D4ryl00/42-badgotron/BADGOTRON/HUGO DESIGN TROP SWAG/niel.png

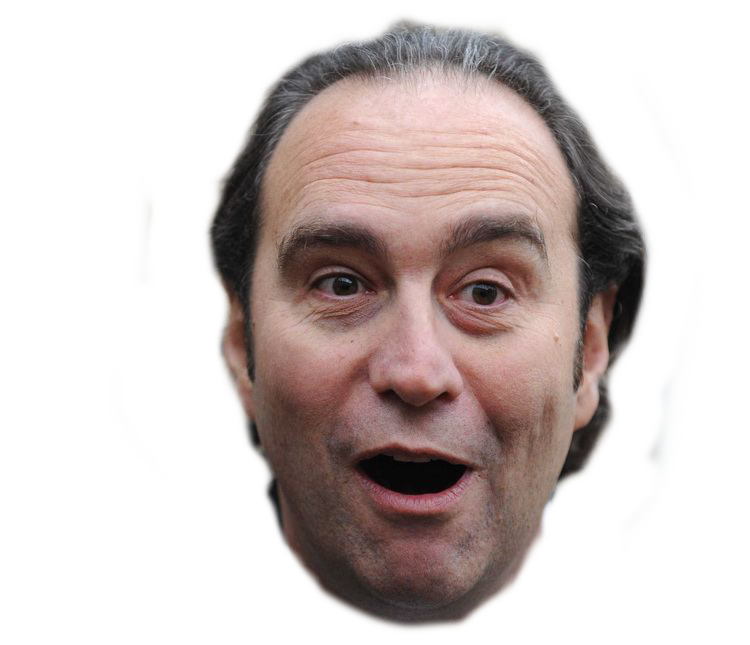
BADGOTRON/HUGO DESIGN TROP SWAG/niel.png
