D4ryl00/42-badgotron/README.md

# 42-badgotron

This is a digital electronic project at 42 (Paris).
Based on Microship PIC32 chip, this access card reader enables us (students) to know how much time we have stayed in the school this day, this week, this month, or this trimester.
