D4ryl00/42-badgotron/BADGOTRON/Firmware/Docs/Notes.txt

Mettre les pins non connectées en output et en low-level.
