D4ryl00/42-badgotron/BADGOTRON/Datasheets/cableRS.PNG

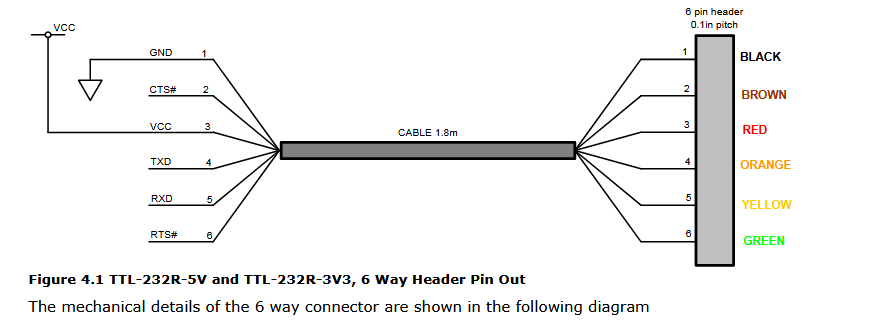
BADGOTRON/Datasheets/cableRS.PNG
