D4ryl00/42-badgotron/BADGOTRON/Firmware/Docs/Lecteur RFID Pont diviseur.PNG

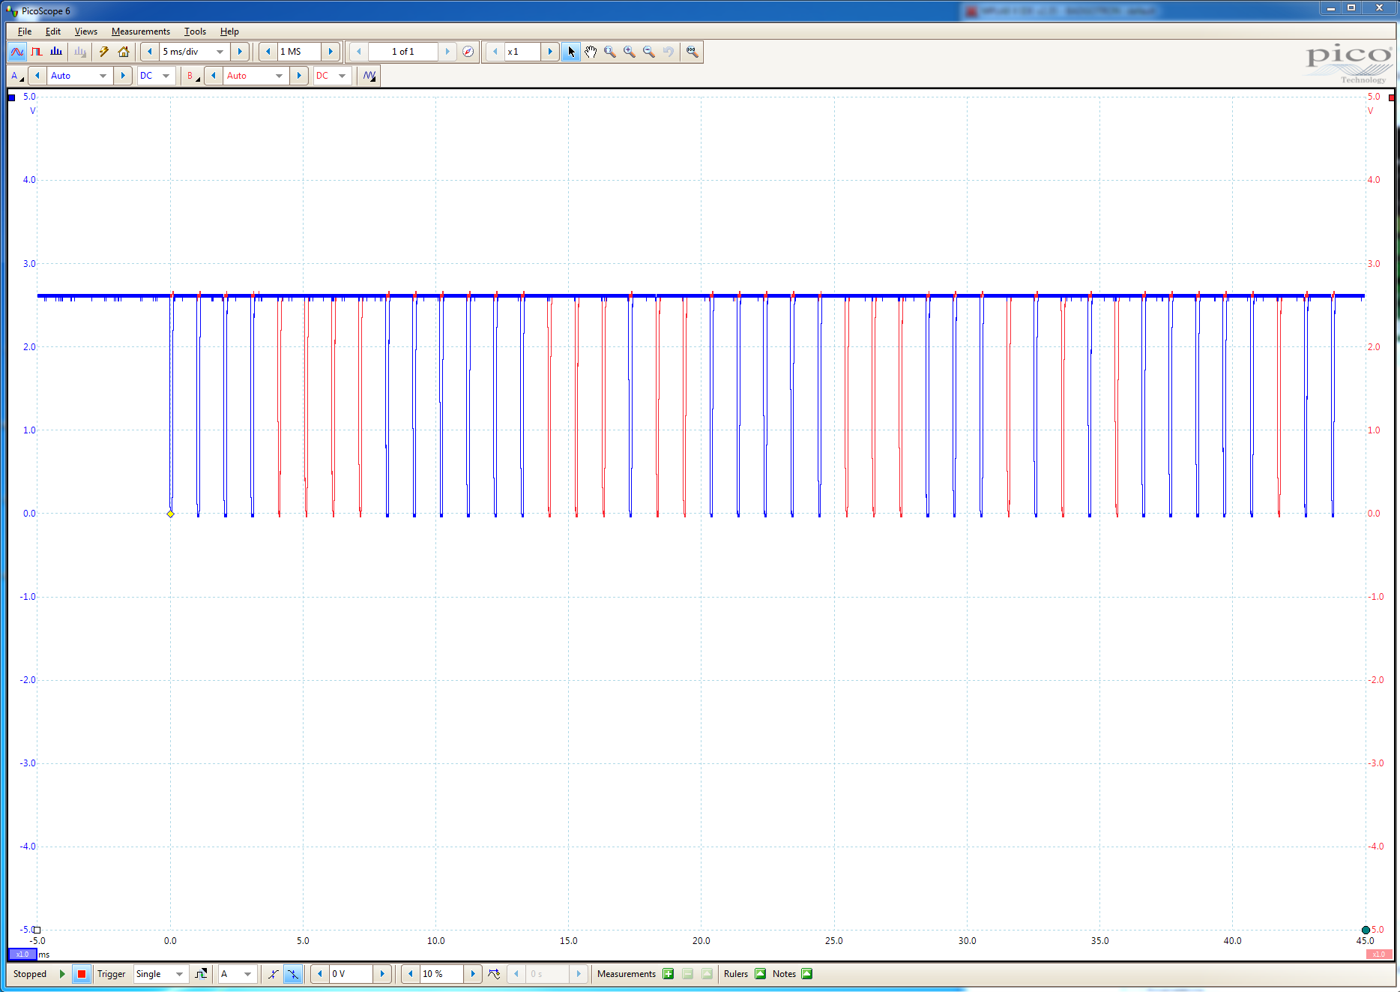
BADGOTRON/Firmware/Docs/Lecteur RFID Pont diviseur.PNG
