D4ryl00/42-badgotron/BADGOTRON/Schemas/Reg.PNG

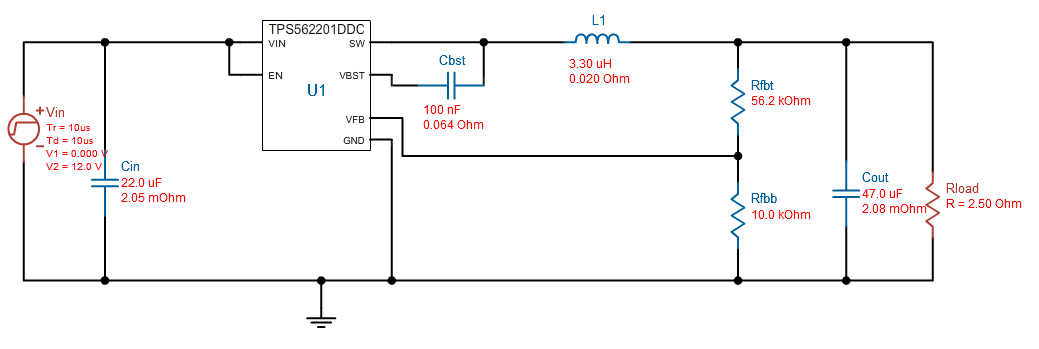
BADGOTRON/Schemas/Reg.PNG
