D4ryl00/42-badgotron/TP2/OUTPUT/BOM/Bill of Materials-PCB_Project_4.xlsx

Quantity | LogicalDesignator | Comment | Footprint | Description | Fabricant | Ref.Fabricant | Fournisseur | Ref.Fournisseur | Precision
7 | C1, C2, C3, C4, C5, C6, C15 | 100nF | CAPC1608N | Capacitor |  |  |  |  | 50V X5R
2 | C7, C8 | 20pF | CAPC1608N | Capacitor |  |  |  |  | 50V X5R
4 | C9, C11, C12, C13 | 10uF | CAPC2012N | Capacitor | TDK | C2012X5R0J106M/1.25 | Farnell | 2309029 | 6.3V X5R 10uF
2 | C10, C14 | 1uF | CAPC1608N | Capacitor |  |  |  |  | 6.3V X5R
5 | D1, D1, D1, D1, D4 | Green LED | LED 0805 | Typical INFRARED GaAs LED | KING BRIGHT | KPT-2012SGC | Farnell | 2099239
2 | D2, D3 | GF1A | 214AC_21 | Default Diode | VISHAY | 6FIA-E3/67A | Farnell | 9549560
1 | FB1 | 600r | INDC1608AN | Inductor | WURTH | 472792651 | Farnell | 1635706
1 | J1 | Program / Debug | RJ12_90 |  | Tyco | 1-215876-3 | Farnell | 1773039
1 | P1 | 12V Main | PHOENIX_1985195 | Header, 2-Pin | PHOENIX CONTACT | PTSA 1.5/2-3,5-Z | Farnell | 1792769
1 | P2 | 12V Battery | PHOENIX_1985195 | Header, 2-Pin | PHOENIX CONTACT | PTSA 1.5/2-3,5-Z | Farnell | 1792769
1 | R1 | 1K | PDB181-K415K-102A2 | Potentiometer | BOURNS | PDB181-K415K-102A2 | Farnell | 1823540
4 | R2 | 330r | RESC1608N | Resistor |  |  |  |  | 1%
1 | R3 | 4.7k | RESC1608N | Resistor |  |  |  |  | 1%
1 | R4 | 470r | RESC1608N | Resistor |  |  |  |  | 1%
1 | U1 | PIC32MX764F128H-I/PT | QFP50P1200X1200X120-64 | PIC32MX764F128H-I/PT | Microchip | PIC32MX764F128H-I/PT | Farnell | 1971889
1 | U2 | AP1117 | TD03B_N |  | DIODES INC | AP1117D33G-13 | Farnell | 1825285
1 | Y1 | 8MHz | HC49/4H SMX Crystal | Crystal Oscillator | FOX ELECTRONICS | FOXSDLF/080-20 | Farnell | 2063972
