D4ryl00/42-badgotron/BADGOTRON/Schemas/Project Outputs for badgotron/BOM/Bill of Materials-badgotron.xlsx

Quantity | Designator | Comment | Footprint | Description | Fabricant | Ref.Fabricant | Fournisseur | Ref.Fournisseur
13 | C8, C10, C12, C14, C15, C16, C17, C18, C19, C20, C21, C22, R9 | 0.1uF, 22uF, 22uF, 10uF, 10uF, 0.1uF, 0.1uF, 22uF, 22uF, 10uF, 10uF, 0.1uF, 33.2K | 0603 | Reg_5v, Reg_5v, Reg_5v, Reg_5v, Reg_5v, Reg_5v, Reg_5v, Reg_5v, Reg_5v, Reg_5v, Reg_5v, Reg_5v, Resistor | CAHIER | CAHIER | CAHIER | CAHIER
4 | C5, C7, C9, C11 | 0.1uF | 0603 | Capacitor | Multicomp | MCY4C3B104M160CT | Farnell | 2310273
3 | R2, R3, R13 | 300k | 0603 | Resistor | MULTICOMP | MCSR08X3003FTL | Farnell | 2074433
3 | R4, R5, R16 | 100k | 0603 | Resistor | MULTICOMP | MCWR06X1003FTL | Farnell | 2447226
3 | R8, R10, R12 | 10K | 0603 | Resistor | TE CONNECTIVITY | CPF0201D10KC1 | Farnell | 2117887
2 | C1, C2 | 18pF | 0603 | Capacitor | AVX | 02013A180JAT2A | Farnell | 1740563
2 | Q1, Q2 | MOSFET-N | nouveau_mosfetN | N-Channel MOSFET | ON SEMICONDUCTOR | 1HN04CH-TL-W | Farnell | 2727912
2 | R6, R14 | 330 | 0603 | Resistor | TE Connectivity | RN73C1J232RBTDF | Farnell | 2687973
2 | U2, U4 | TPS562201DDCT | TPS562201DDCT | Reg 12V-5V | TPS562201DDCT | Texas Instrument | Farnell | 2527034
1 |  | Lecteur_Badge_LXM |  |  | Stid-Security | LXM_WIEGAND44b | Gregoire | :)
1 | B1 | Motor Servo | RAD-0.4 | Servo Motor | Olimex | MS-R-1.3-9 | Olimex | MS-R-1.3-9
1 | C13 | 1000uF | Condo_trav | Capacitor | Multicomp | MCGLR16V108M10X16 | Farnell | 1902972
1 | C3 | 10uF | C3 |  | VISHAY | TL3C106K025C0450.. | Farnell | 2353238
1 | C4 | 100nF | 0603 | Capacitor | WURTH ELECTRONIK | 885342211005 | Farnell | 2812613
1 | C6 | 22uF | 0603 | Cout_Reg_3.3v | AVX | 12103D226KAT2A | Farnell | 1833829
1 | D1 | Diode 10TQ035 | DiodeZin | Diode Zenner | ON SEMICONDUCTOR | MM3Z15VB | Farnell | 2453991
1 | D4 | LedBlancheRetroEcl | LED-0 | LED Blanche retro vumetre | N/A | N/A | BARBIE | N/A
1 | DS1 | 20x4 LCD |  |  | Midas | MC42008A6W-FPTLW | Farnell | 2606880
1 | F1 | Fuse 1 | FUSIBLE | Fuse | Littelfuse | 39515000000 | Farnell | 1596504
1 | L1 | 4.7uH | Bobine Traversante 4.7 | L_Reg_5v | BOURNS | RLB0914-4R7ML | Farnell | 2309248
1 | L2 | 3.3uH | Bobine Traversante 4.7 | L_Reg_3v | BOURNS | RLB0912-3R3ML | Farnell | 2309234
1 | MCL039PURGW | Led RG |  | Led RG | Multicomp | MCL039PURGW | Farnell | 1581194
1 | P1 | 61304021121 | HDR2X5 | Header, 5-Pin, Dual row | WURTH ELEKTRONIK | 61304021121 | Farnell | 2356148
1 | P2 | 31101112 | Bornier12 | Header, 12-Pin | METZ CONNECT | 31101112 | Farnell | 1909750
1 | P3 | 90512-001LF | RJ12 | PortRJ12_debug | Amphenol ICC | 90512-001LF | Farnell | 1097914
1 | P4 | FC681465P | JackAlim | Power connector | CLIFF | FC681465P | Farnell | 1854512
1 | P5 | BCS-116-L-S-TE | HDR1X12 | Header, 12-Pin | Samtec | BCS-116-L-S-TE | Farnell | 1667483
1 | PS1 | Support Pile | Pile | Support Pile | Renata | SMTU-1225-1-LF | Farnell | 1216353
1 | R1 | 20k | POTARD | Potentiometer | VISHAY | M63S203KB40 | Farnell | 9609822
1 | R11 | 1Ko | 0603 | Resistor | TE CONNECTIVITY | CPF0201D1K0E1 | Farnell | 2117780
1 | R17 | 60.4 | 0603 | Resistor | TE CONNECTIVITY | RP73PF1E60R4BTDF | Farnell | 2838800
1 | R18 | 75 | 0603 | Resistor | TE CONNECTIVITY | CPF0805B75RE1 | Farnell | 1697415
1 | R7 | 54.9K | 0603 | Resistor | TE CONNECTIVITY | CPF0402B54K9E1 | Farnell | 2330744
1 | S1 | Bouton Status | SPST-2 | Switch | RAFI | 1.10.001.001/0205 | Farnell | 9927360
1 | U1 | 74LVX4245MTCX | TRANS | Bus Transceiver | ON SEMICONDUCTOR | 74LVX4245MTCX | Farnell | 1467357
1 | U3 | SST25VF016B-50-4C-S2AF-T | FLASH | FLASH | Microchip | SST25VF016B-50-4I-S2AF-T | Farnell | 2774943
1 | U6 | LM809M3-3.08/NOPB | LM809 | Voltage Monitor | TEXAS INSTRUMENTS | LM809M3-3.08/NOPB | Farnell | 2352609
1 | U7 | MCP79510-I/MS | rtc | RTC | Microchip | MCP79510-I/MS | Farnell | 2361124
1 | XDS1 | 1-826629-6 | HDR1X16 | Header, 16-Pin | AMP-TE CONNECTIVITY | 1-826629-6 | Farnell | 1248124
1 | Y1 | 32.768kHz | QUARTZ32KHz | Crystal Oscillator | ABRACON | ABS07-32.768KHZ-7-T | Farnell | 1838935
1 | Z1 | PIC32MX170F256D-I/PT | TQFP-44_L | PIC | MICROCHIP | PIC32MX170F256D-I/PT | Farnell | 2456845
