D4ryl00/42-badgotron/Sujets/Hardware/TP2/Bill of Materials/Bill of Materials.xls

BILL OF MATERIALS
Projet : |  | TP2.PrjPcb |  |  | Toutes résistances 1% sauf indication contraire
Date creation : |  | 28/01/2015 | 17:28:42 |  | Tous condensateurs X5R 6.3V minimum sauf indication contraire
Date impression : |  | 2015-01-28 | 17:28:44 |  | Condensateurs <= 100nF : C0G ou NP0 préférables
Quantity | LogicalDesignator | Comment | Footprint | Description | Fabricant | RefFabricant | Fournisseur | RefFournisseur | Precision | #Column Name Error:Notes
7 | C1, C2, C3, C4, C5, C6, C15 | 100nF | CAPC1608N | Capacitor |  |  |  |  | 50V X5R
2 | C7, C8 | 20pF | CAPC1005N | Capacitor |  |  |  |  | 50V X5R
4 | C9, C11, C12, C13 | 10uF | CAPC2012N | Capacitor | TDK | C2012X5R0J106M/1.25 | Farnell | 2309029 | 6,3V X5R
2 | C10, C14 | 1uF | CAPC1608N | Capacitor |  |  |  |  | 6,3V X5R
5 | D1, D1, D1, D1, D4 | Green LED | LED 0805 | Typical INFRARED GaAs LED | KINGBRIGHT | KPT-2012SGC | Farnell | 2099239
2 | D2, D3 | GF1A | SMA/DO-214AC_21 | Default Diode | VISHAY | GF1A-E3/67A | Farnell | 9549560
1 | FB1 | 600r | INDC1608AN | Inductor | Wurth | 742792651 | Farnell | 1635706
1 | J1 | Program / Debug | MOLEX 6P 1.25 CMS |  | Molex | 53398-0671 | Farnell | 1125368
1 | P1 | 12V Main | PHOENIX_1985195 | Header, 2-Pin | PHOENIX CONTACT | PTSA 1.5/2-3,5-Z | Farnell | 1792769
1 | P2 | 12V Battery | PHOENIX_1985195 | Header, 2-Pin | PHOENIX CONTACT | PTSA 1.5/2-3,5-Z | Farnell | 1792769
1 | R1 | 1K | PDB181-K415K-102A2 | Potentiometer | BOURNS | PDB181-K415K-102A2 | Farnell | 1823540
4 | R2 | 330r | RESC1608N | Resistor |  |  |  |  | 1%
1 | R3 | 4.7k | RESC1608N | Resistor |  |  |  |  | 1%
1 | R4 | 470r | RESC1608N | Resistor |  |  |  |  | 1%
1 | U1 | PIC32MX764F128H-I/PT | QFP50P1200X1200X120-64 | PIC32MX764F128H | Microchip | PIC32MX764F128H-I/PT | Farnell | 1971889
1 | U2 | AP1117 | TD03B_N | 1A LDO, 18V input, DPAK | DIODES INC | AP1117D33G-13 | Farnell | 1825285
1 | Y1 | 8MHz | XTAL139X50X45 | Crystal Oscillator | FOX ELECTRONICS | FOXSDLF/080-20 | Farnell | 2063972
