D4ryl00/42-badgotron/TP2/ZZ-POUBELLEPASSUR/Project Outputs for Free Documents/BOM/Bill of Materials-PCB_Project_4.xlsx

Comment | Description | Designator | Footprint | LibRef | Quantity
100nF | Capacitor | C1, C2, C3, C4, C5, C6, C15 | RAD-0.3 | Cap | 7
20pF | Capacitor | C7, C8 | RAD-0.3 | Cap | 2
10uF | Capacitor | C9, C11, C12, C13 | RAD-0.3 | Cap | 4
1uF | Capacitor | C10, C14 | RAD-0.3 | Cap | 2
Green LED | Typical INFRARED GaAs LED | D1_LED0, D1_LED1, D1_LED2, D1_LED3, D4 | LED-0 | LED0 | 5
GF1A | Default Diode | D2, D3 | SMC | Diode | 2
600r | Inductor | FB1 | 0402-A | Inductor | 1
Program / Debug |  | J1 |  | Program / Debug | 1
12V Main | Header, 2-Pin | P1 | HDR1X2 | Header 2 | 1
12V Battery | Header, 2-Pin | P2 | HDR1X2 | Header 2 | 1
1K | Potentiometer | R1 | VR5 | RPot | 1
330r | Resistor | R2_LED0, R2_LED1, R2_LED2, R2_LED3 | AXIAL-0.3 | Res1 | 4
4.7k | Resistor | R3 | AXIAL-0.3 | Res1 | 1
470r | Resistor | R4 | AXIAL-0.3 | Res1 | 1
AP1117 |  | U2 |  | AP1117 | 1
PIC32MX764F128H-I/PT |  | U? |  | PIC32MX764F128H-I/PT | 1
8MHz | Crystal Oscillator | Y1 | R38 | XTAL | 1
