D4ryl00/42-badgotron/BADGOTRON/Schemas/Project Outputs for badgotron/Schematic Prints/Schematic Prints.PDF

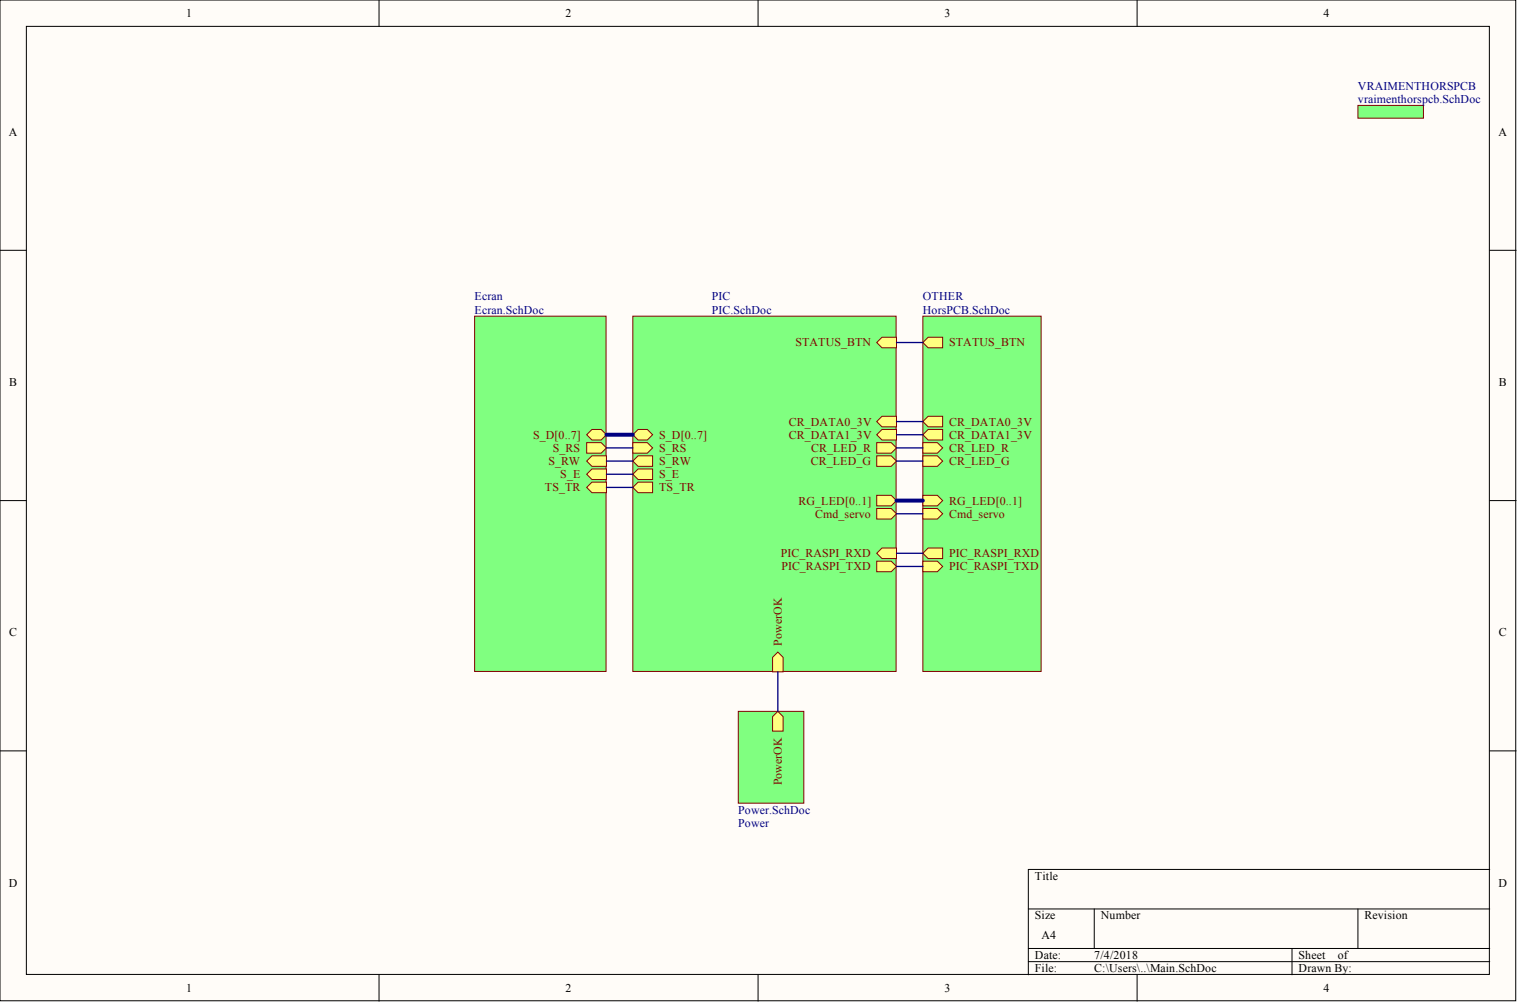
[picture p5: page 1]

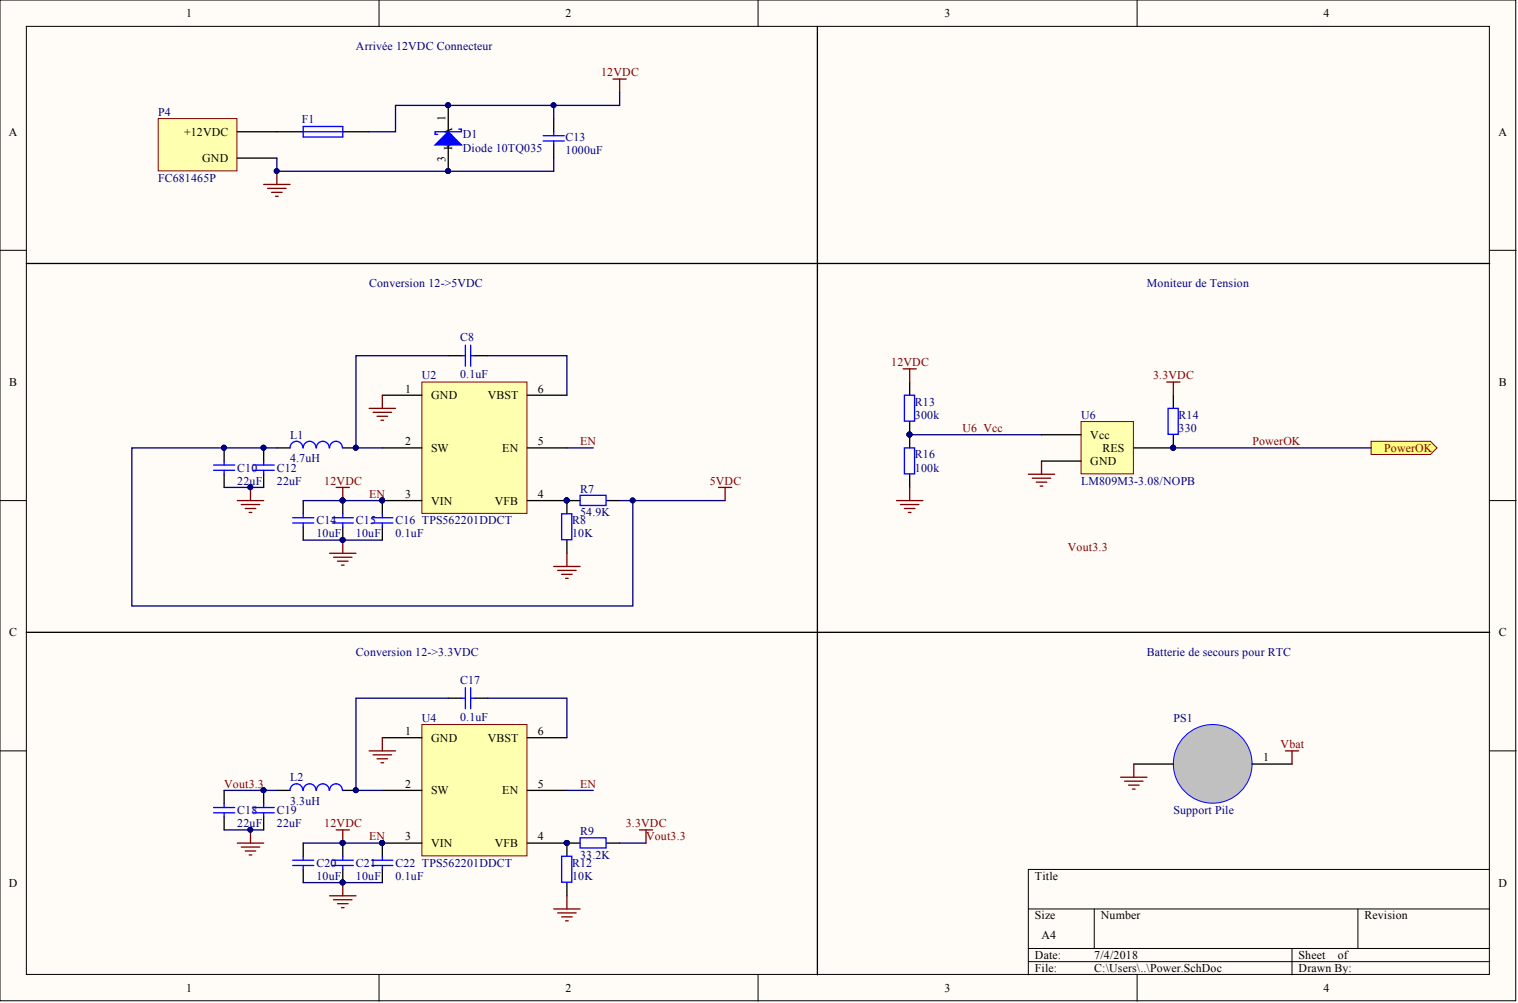
[picture p6: page 2]

Batterie de secours pour RTC

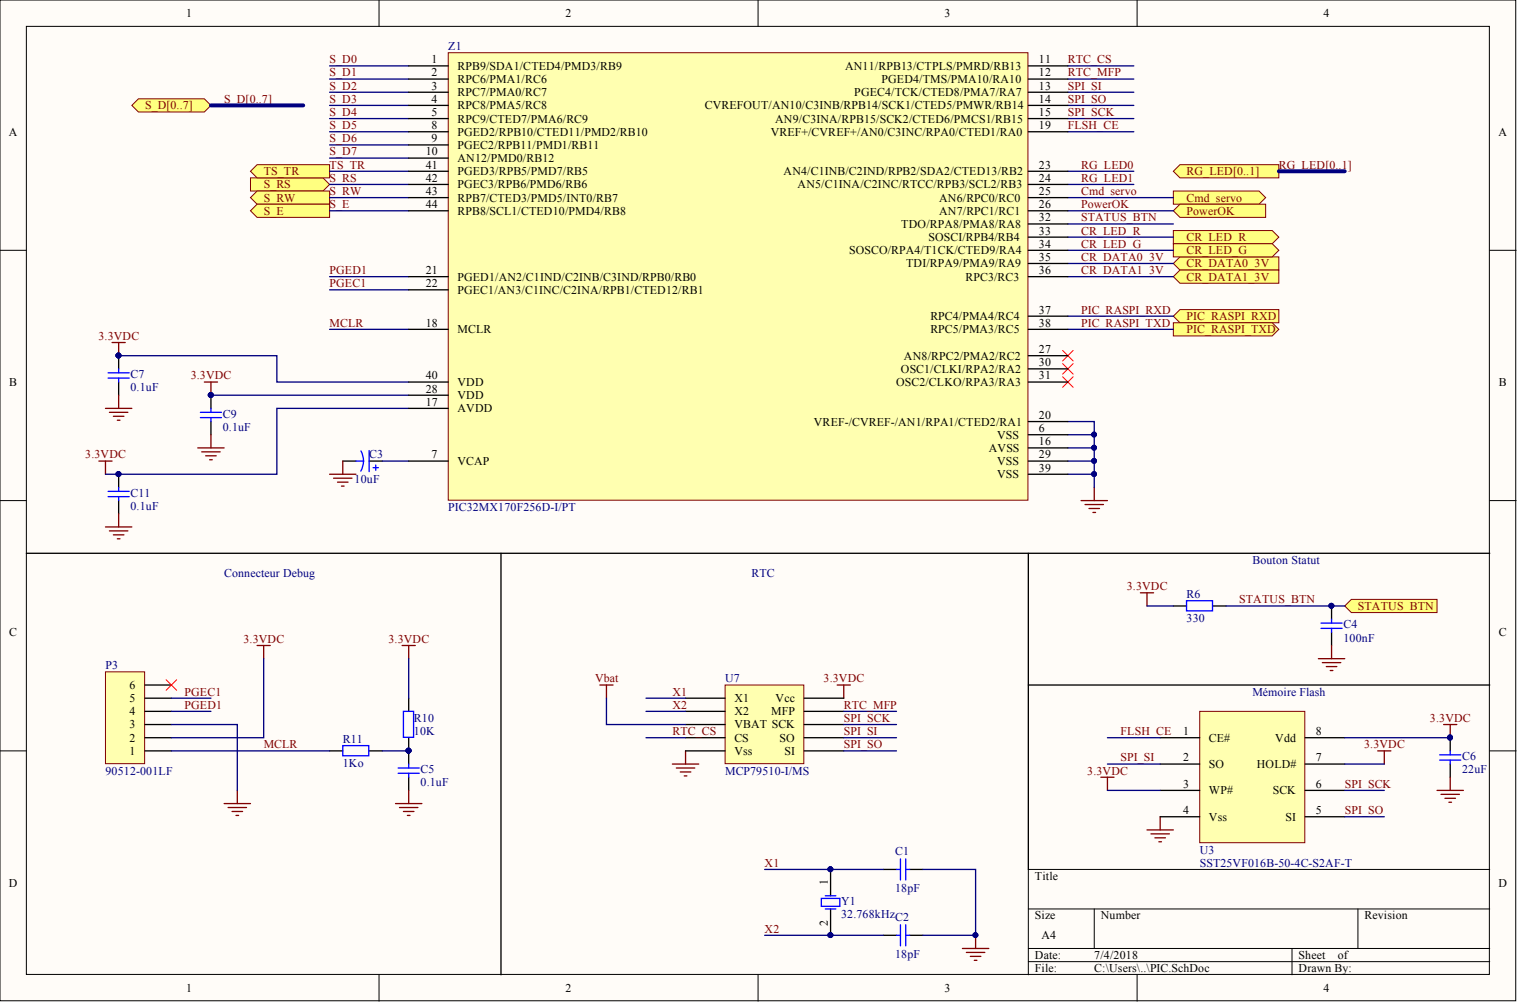
[picture p7: page 3]

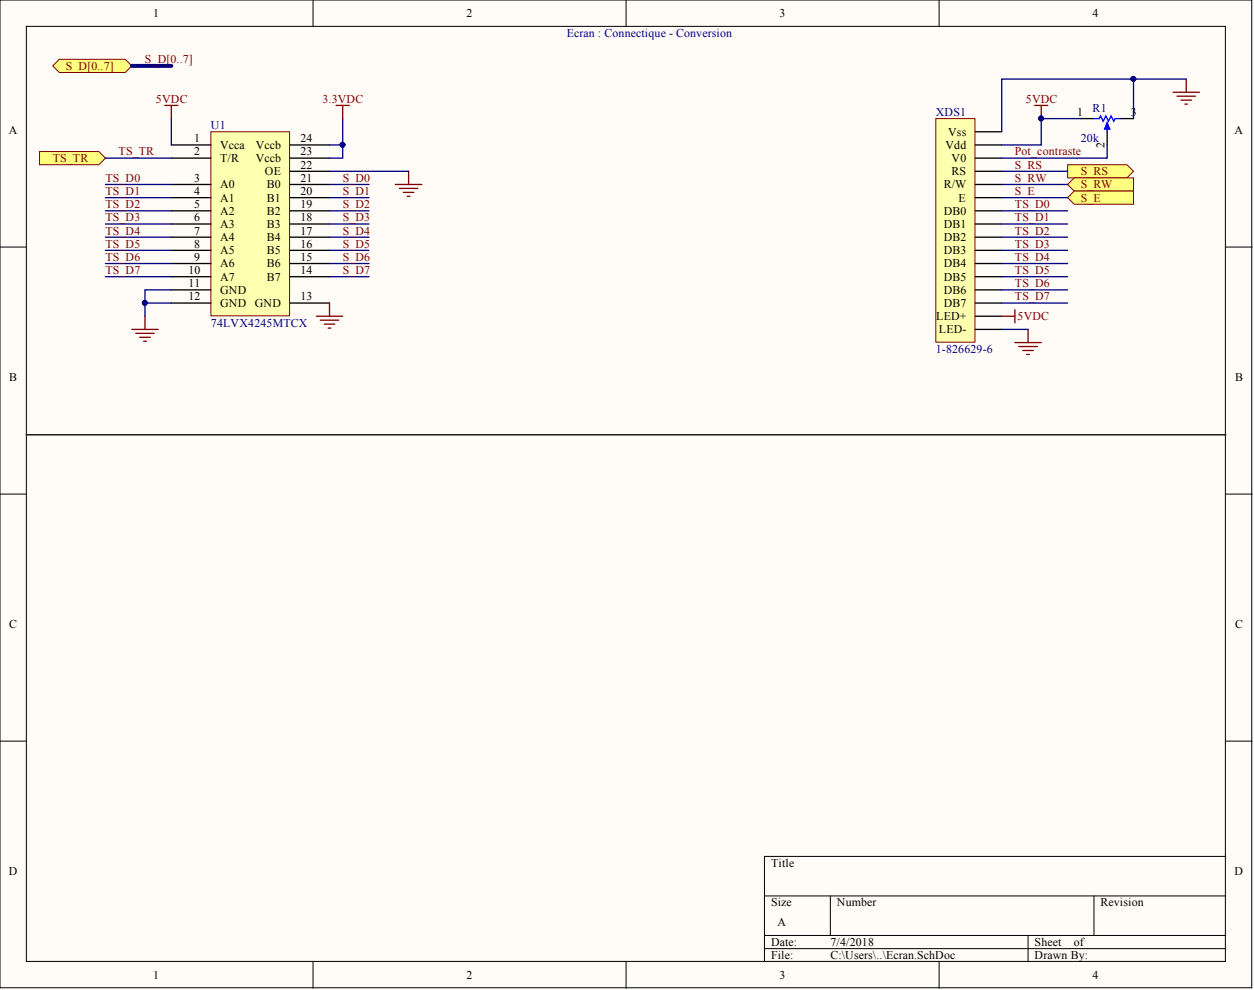
[picture p8: page 4]

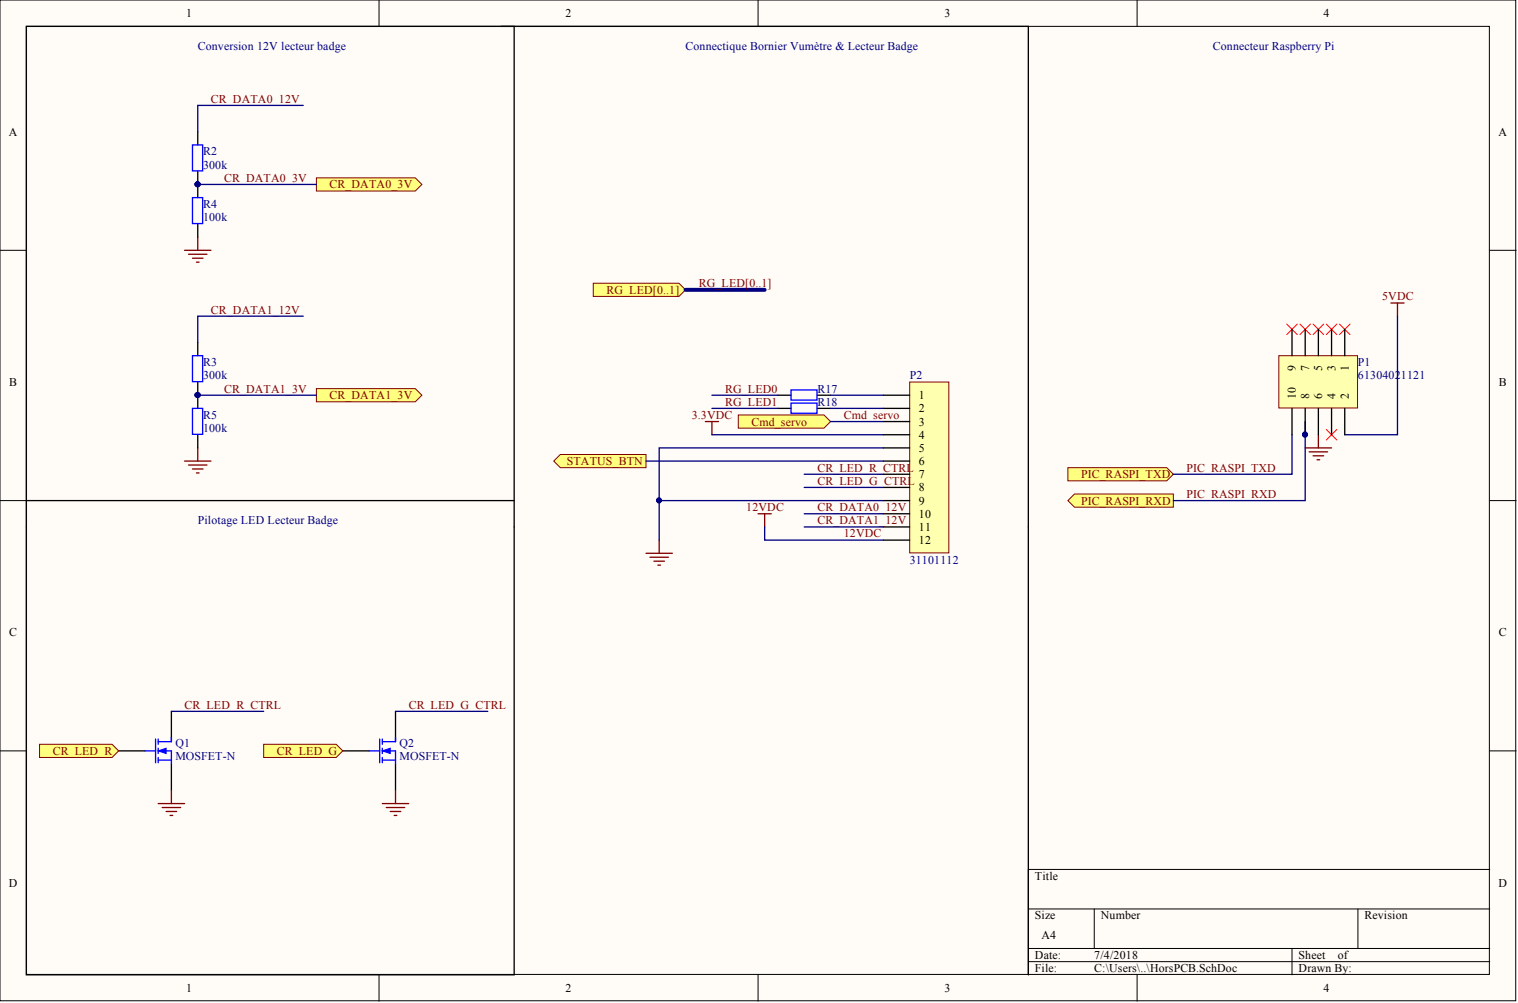
[picture p9: page 5]

Connectique Bornier Vumètre & Lecteur Badge

CR_LED_R_CTRL CR_LED_G_CTRL

12VDC CR_DATA0_12V

Pilotage LED Lecteur Badge

12VDC | 11 12

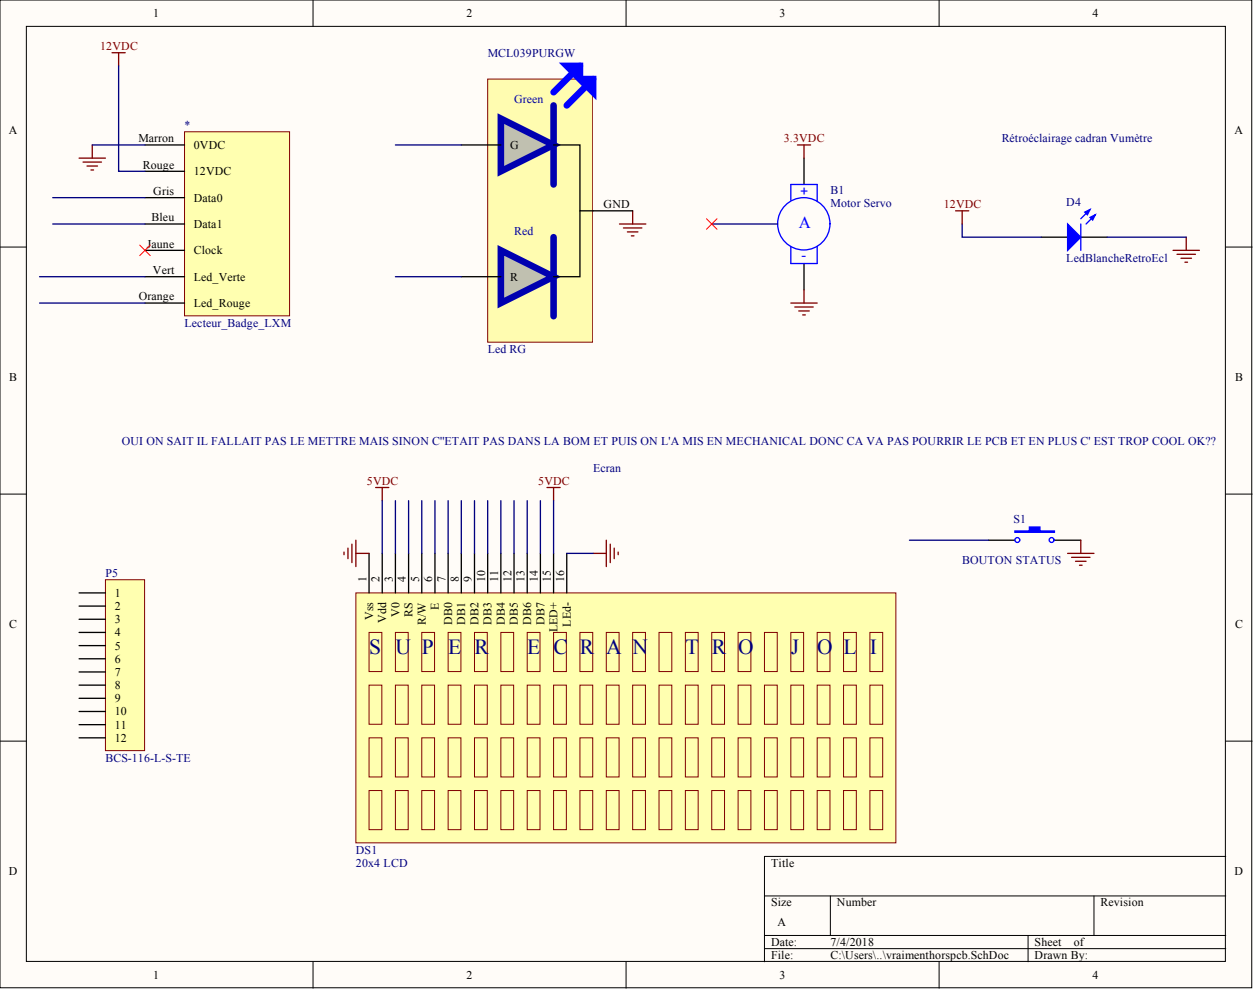
[picture p10: page 6]

OUI ON SAIT IL FALLAIT PAS LE METTRE MAIS SINON C''ETAIT PAS DANS LA BOM ET PUIS ON L'A MIS EN MECHANICAL DONC CA VA PAS POURRIR LE PCB ET EN PLUS C' EST TROP COOL OK??
