D4ryl00/42-badgotron/BADGOTRON/Schemas/Schemas_Annotes_19.04.pdf

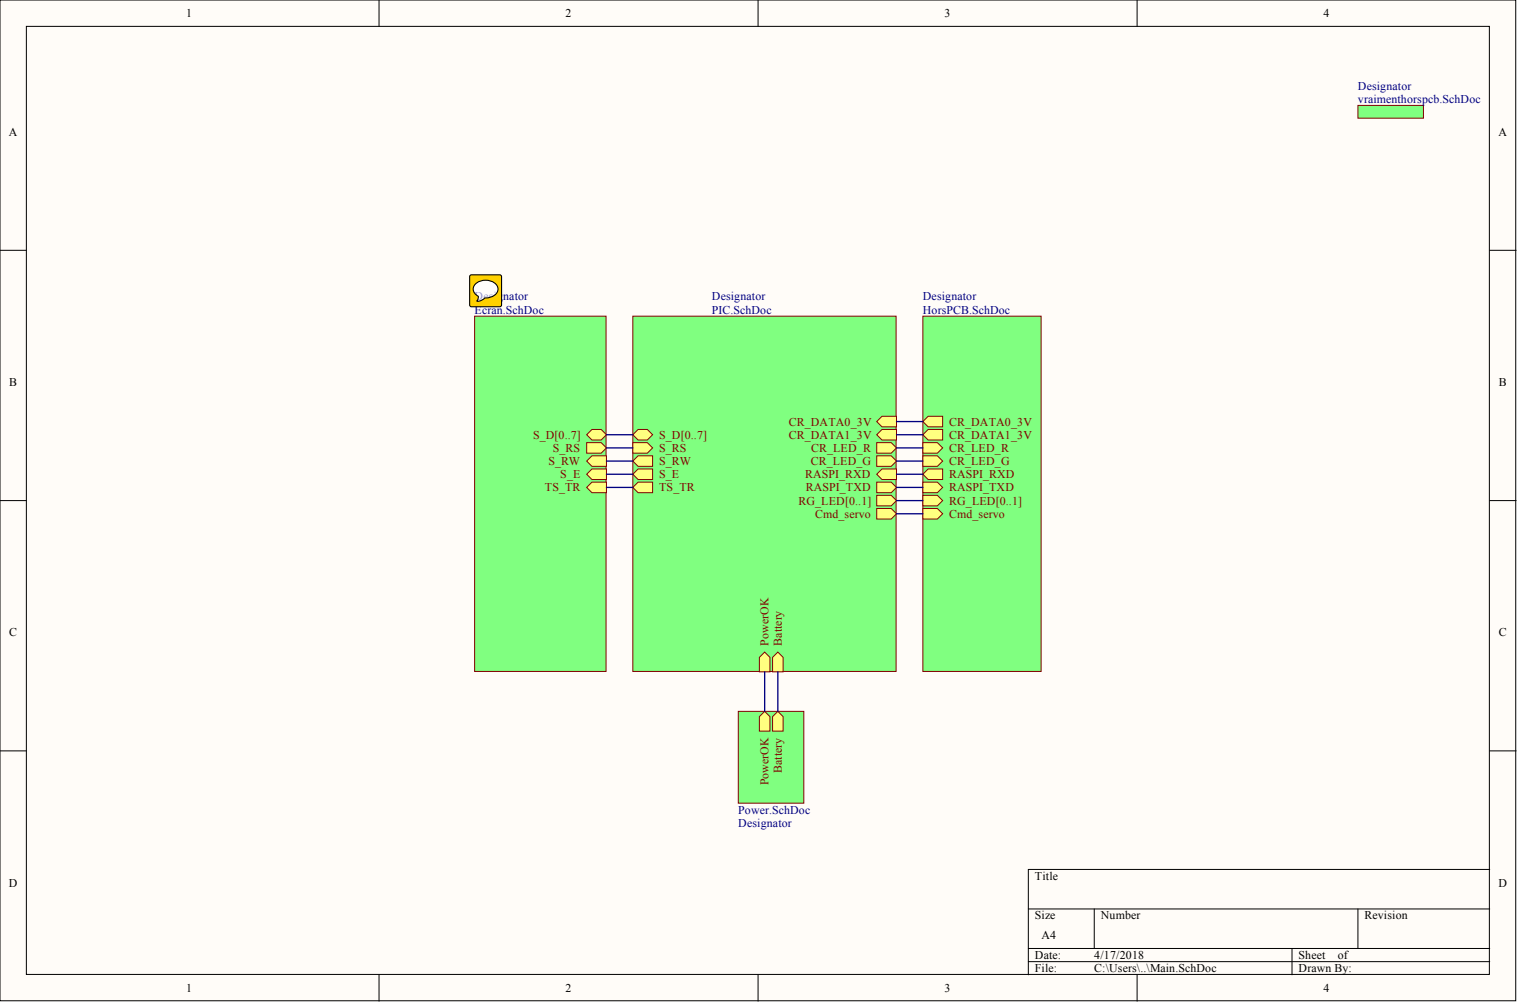
[picture p11: page 1]

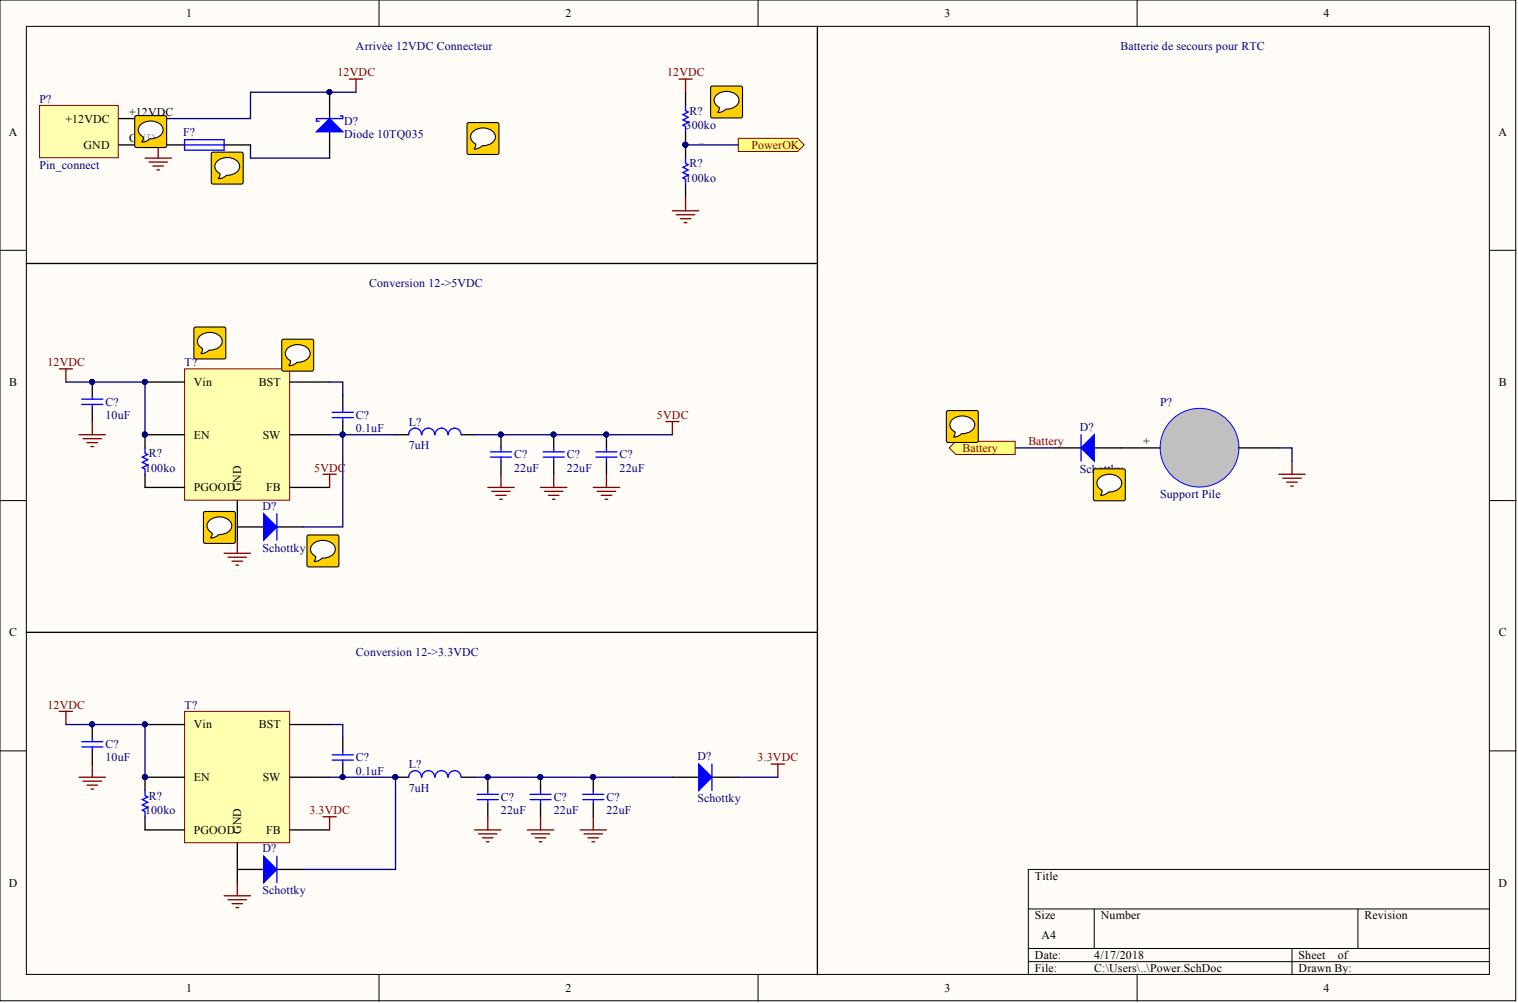
[picture p12: page 2]

Batterie de secours pour RTC

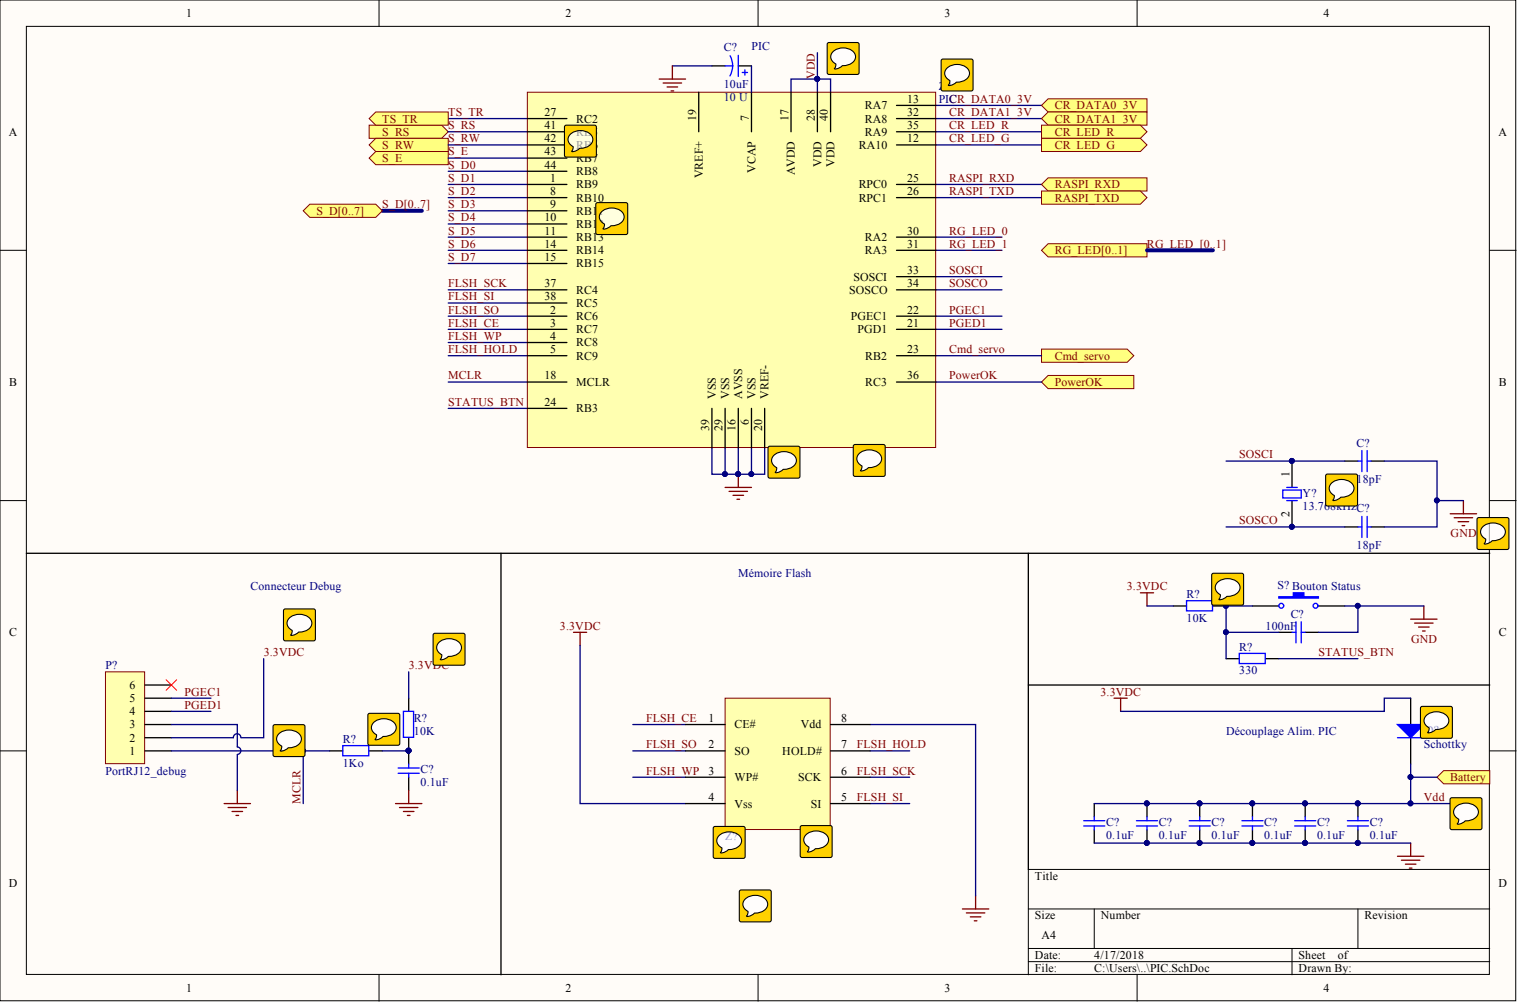
[picture p13: page 3]

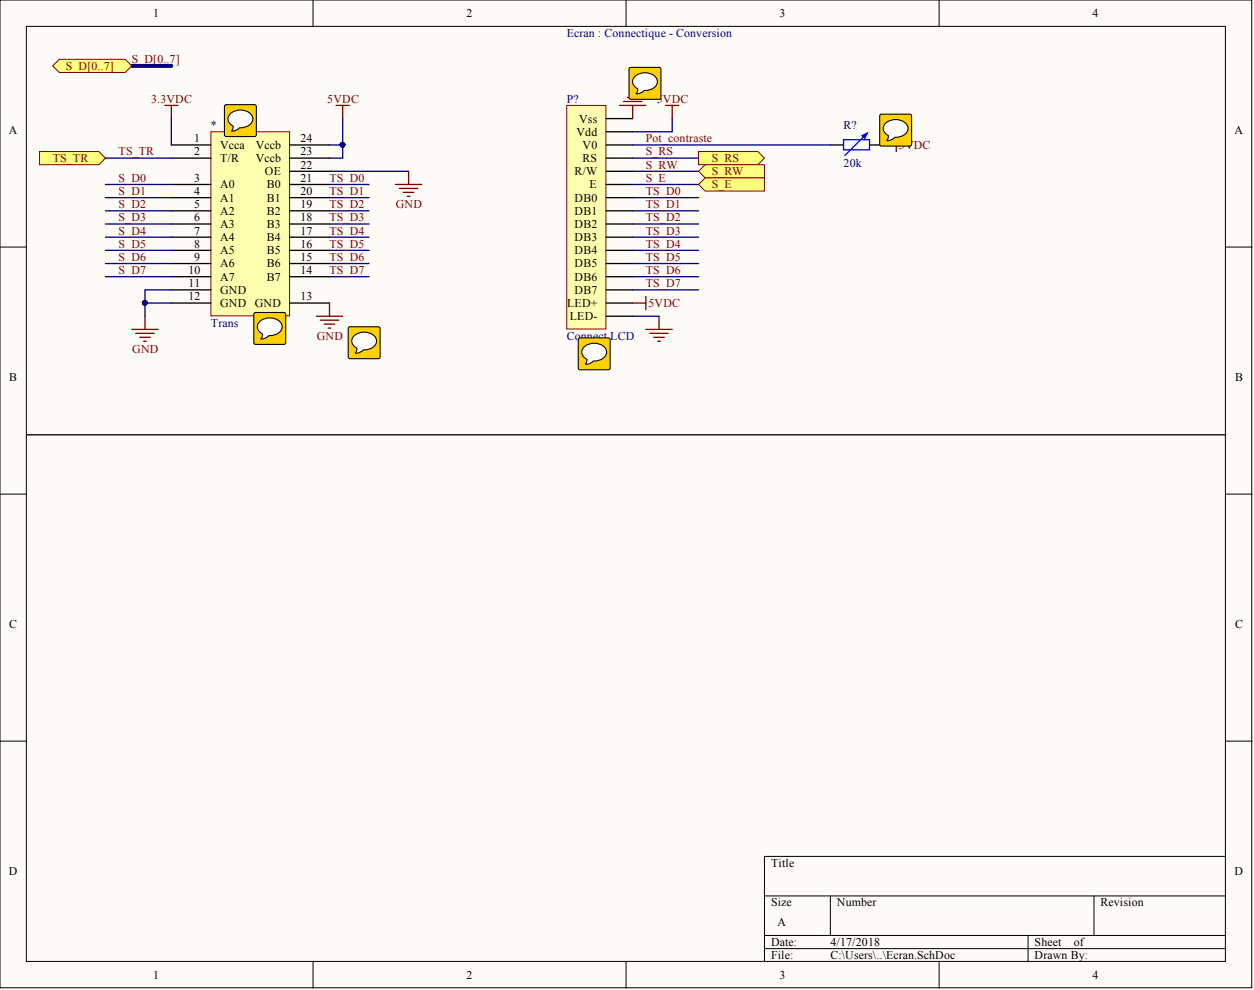
[picture p14: page 4]

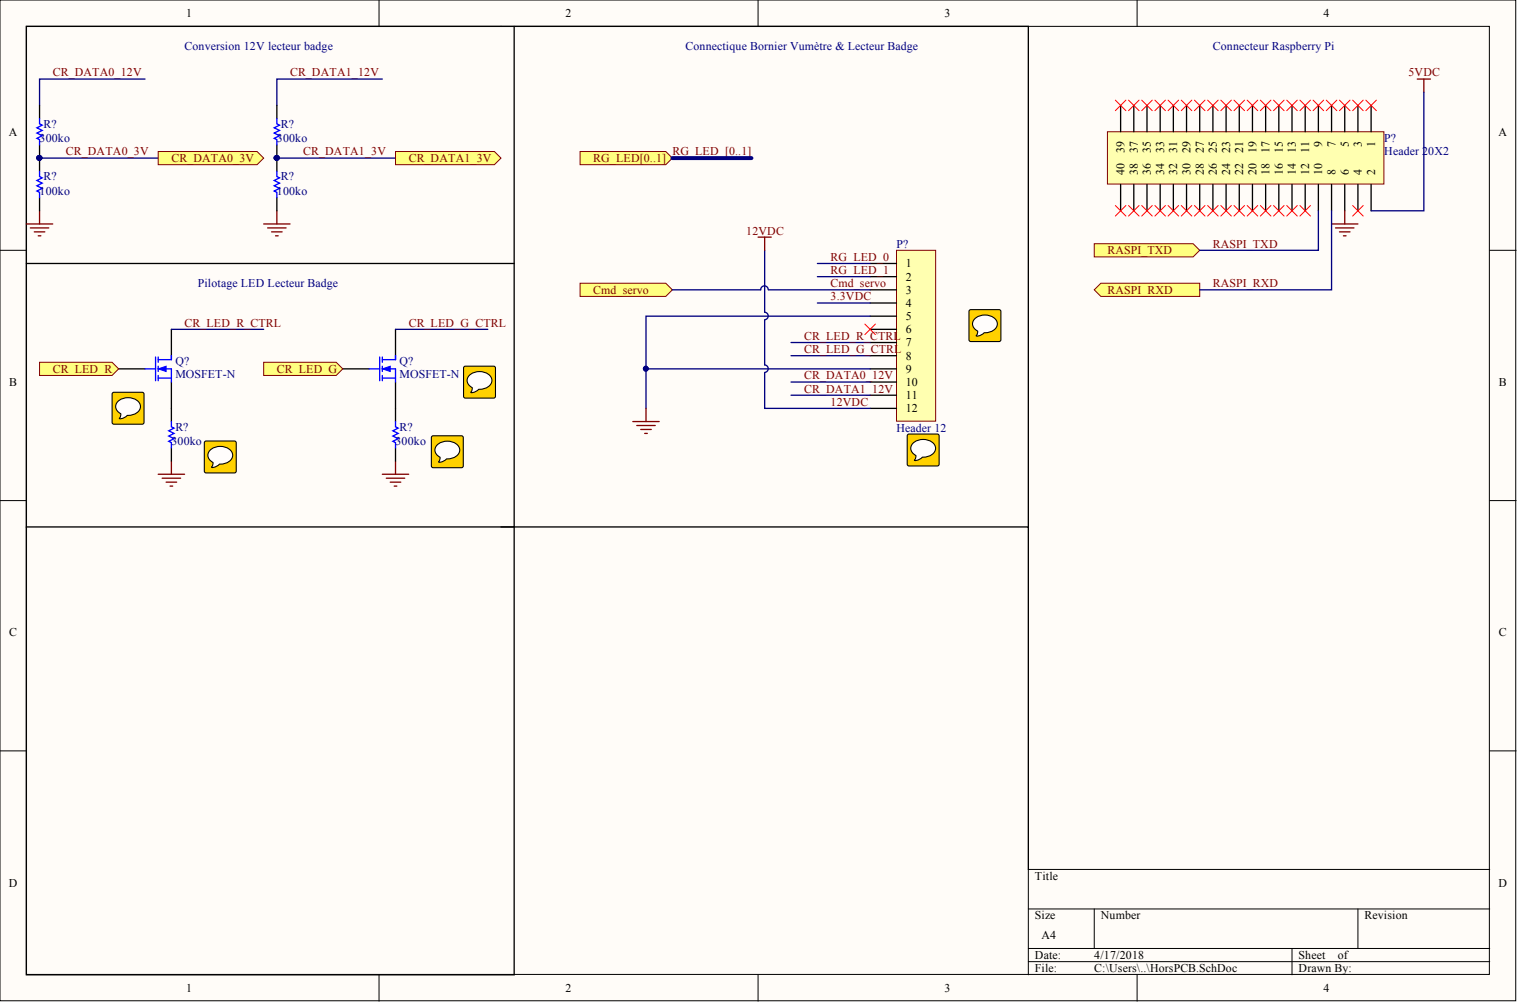
[picture p15: page 5]

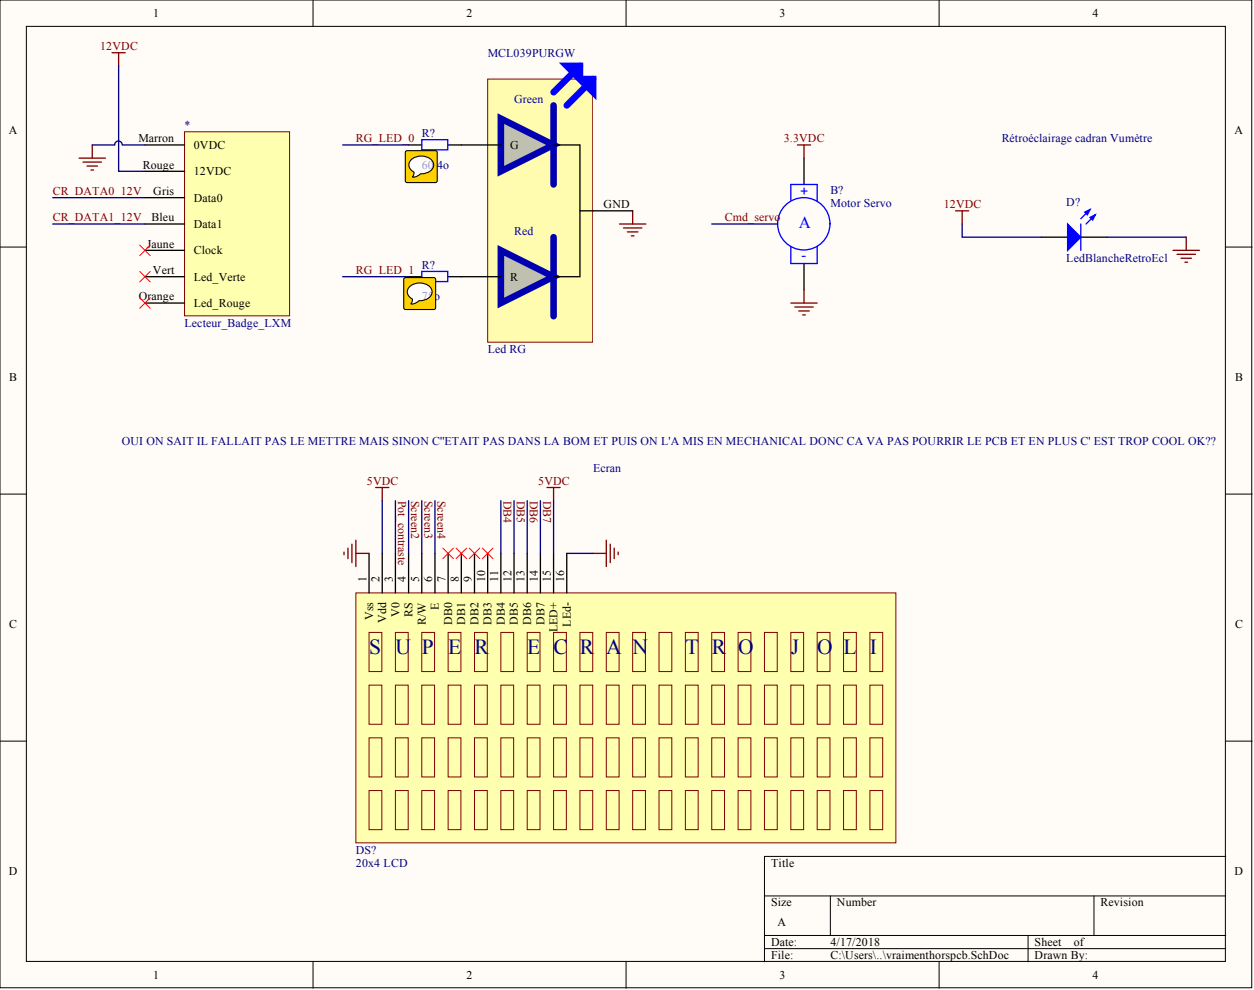
[picture p16: page 6]

OUI ON SAIT IL FALLAIT PAS LE METTRE MAIS SINON C''ETAIT PAS DANS LA BOM ET PUIS ON L'A MIS EN MECHANICAL DONC CA VA PAS POURRIR LE PCB ET EN PLUS C' EST TROP COOL OK??
