D4ryl00/42-badgotron/BADGOTRON/HUGO DESIGN TROP SWAG/vumetre.pdf

0

35

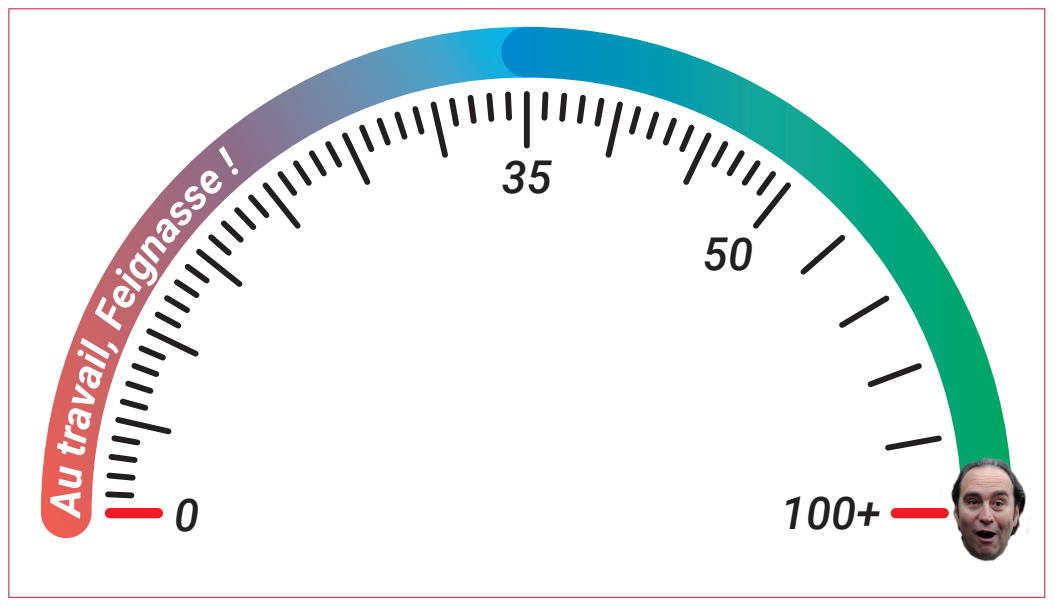
[picture p17: page 1]
u travail, Feignasse !
