D4ryl00/42-badgotron/TP2/OUTPUT/Schematic Prints/Schematic Prints.PDF

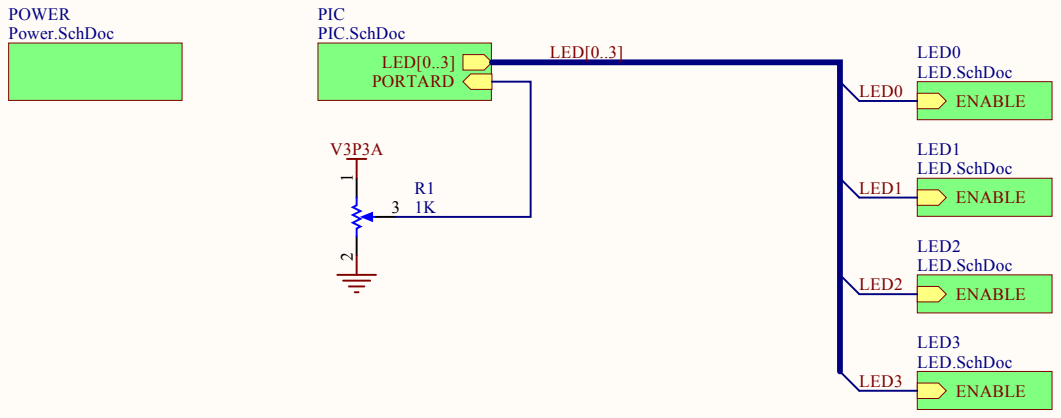
[picture p18: page 1]

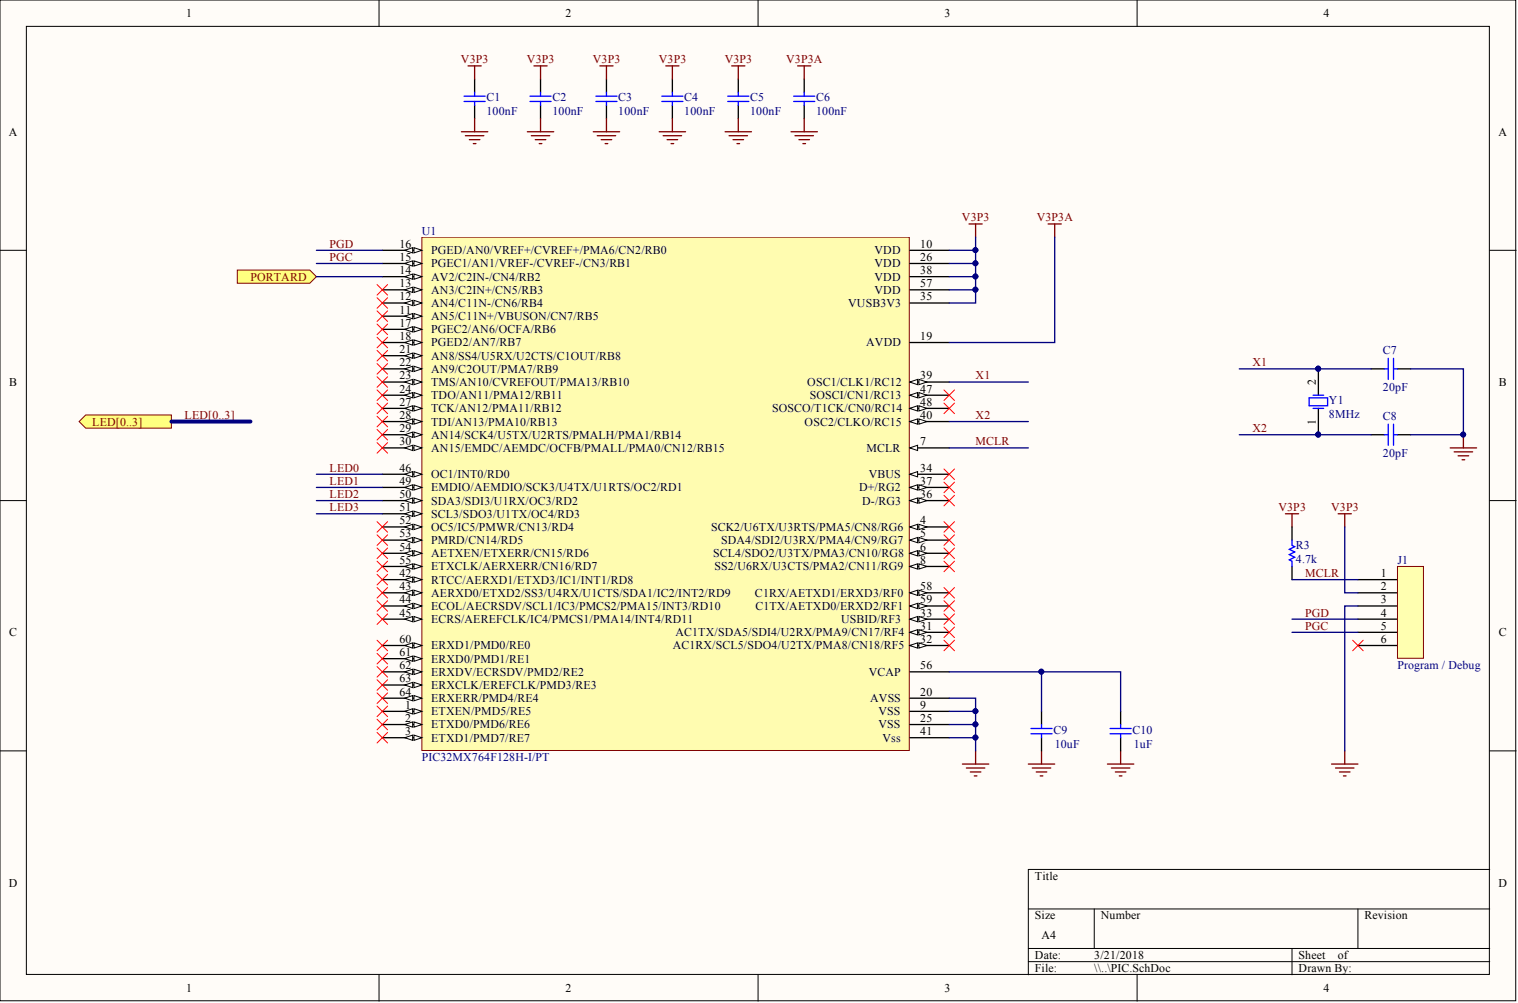
[picture p19: page 2]

2 6
3 8
5 7
3 5

2 0
2 5
4 1

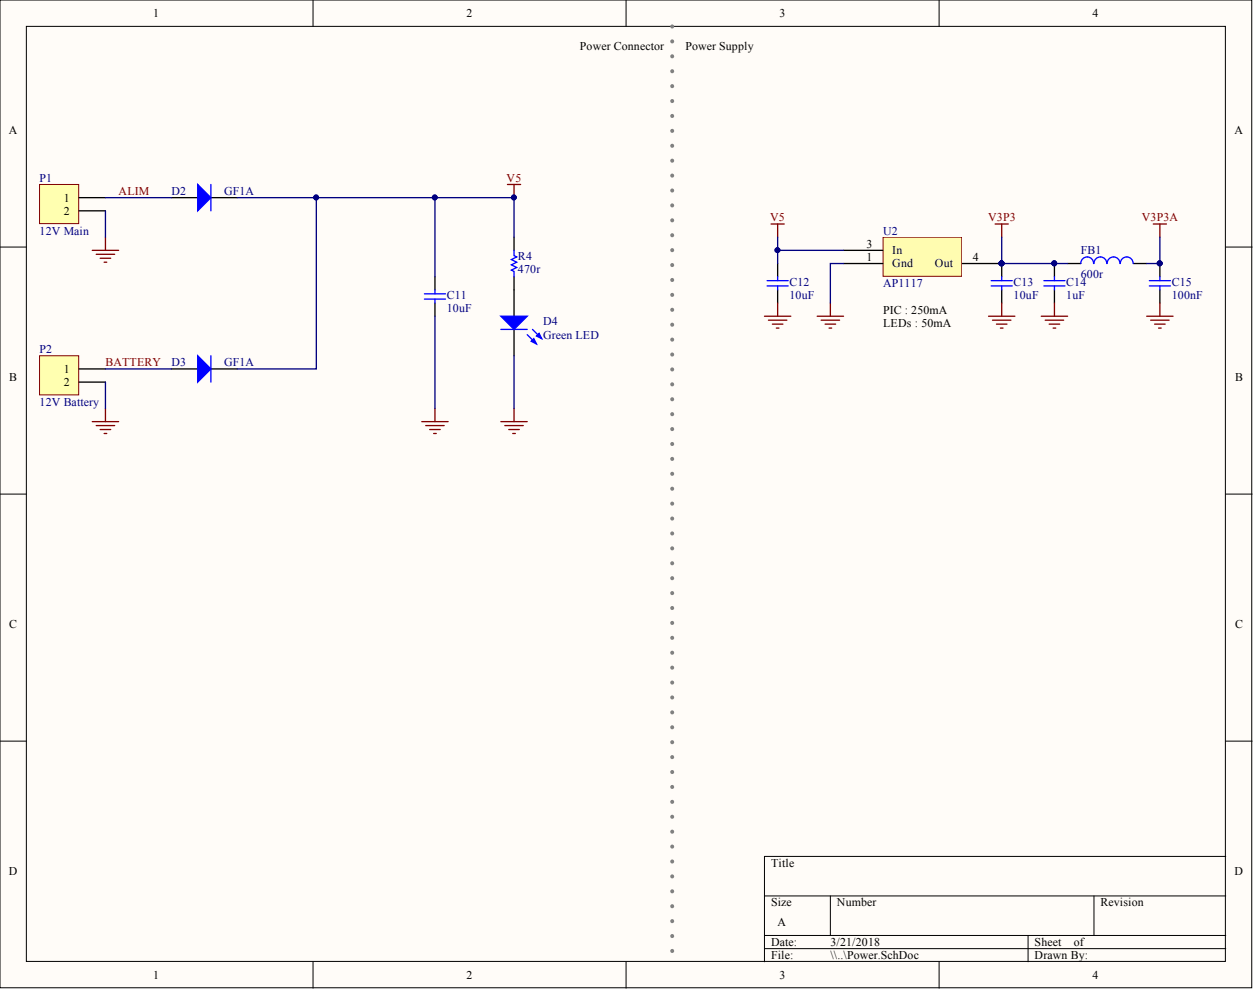
[picture p20: page 3]

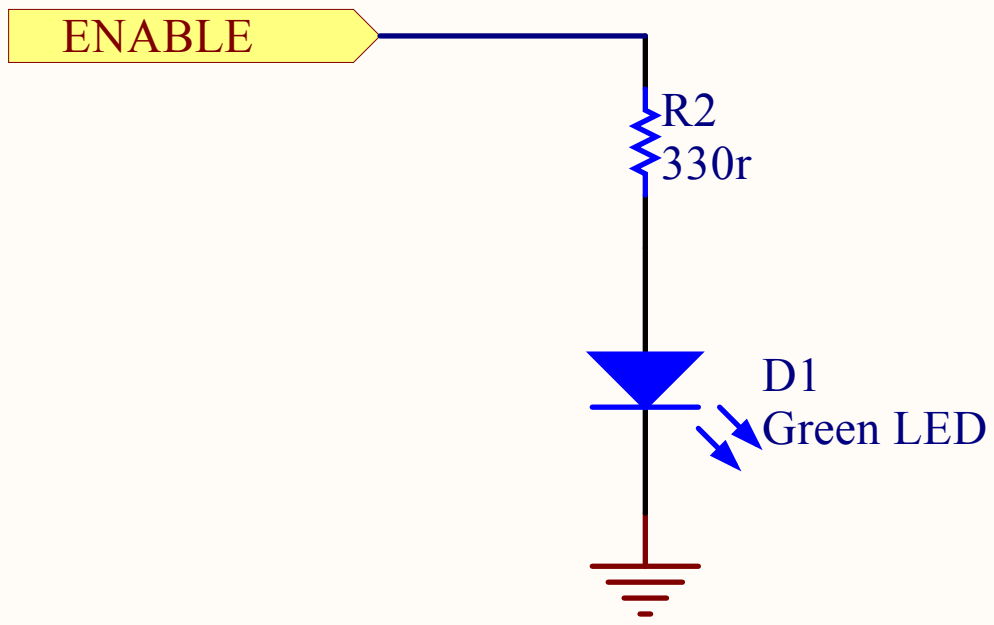
[picture p21: page 4]
