D4ryl00/42-badgotron/TP2/OUTPUT/Assembly Drawings/Assembly Drawings.PDF

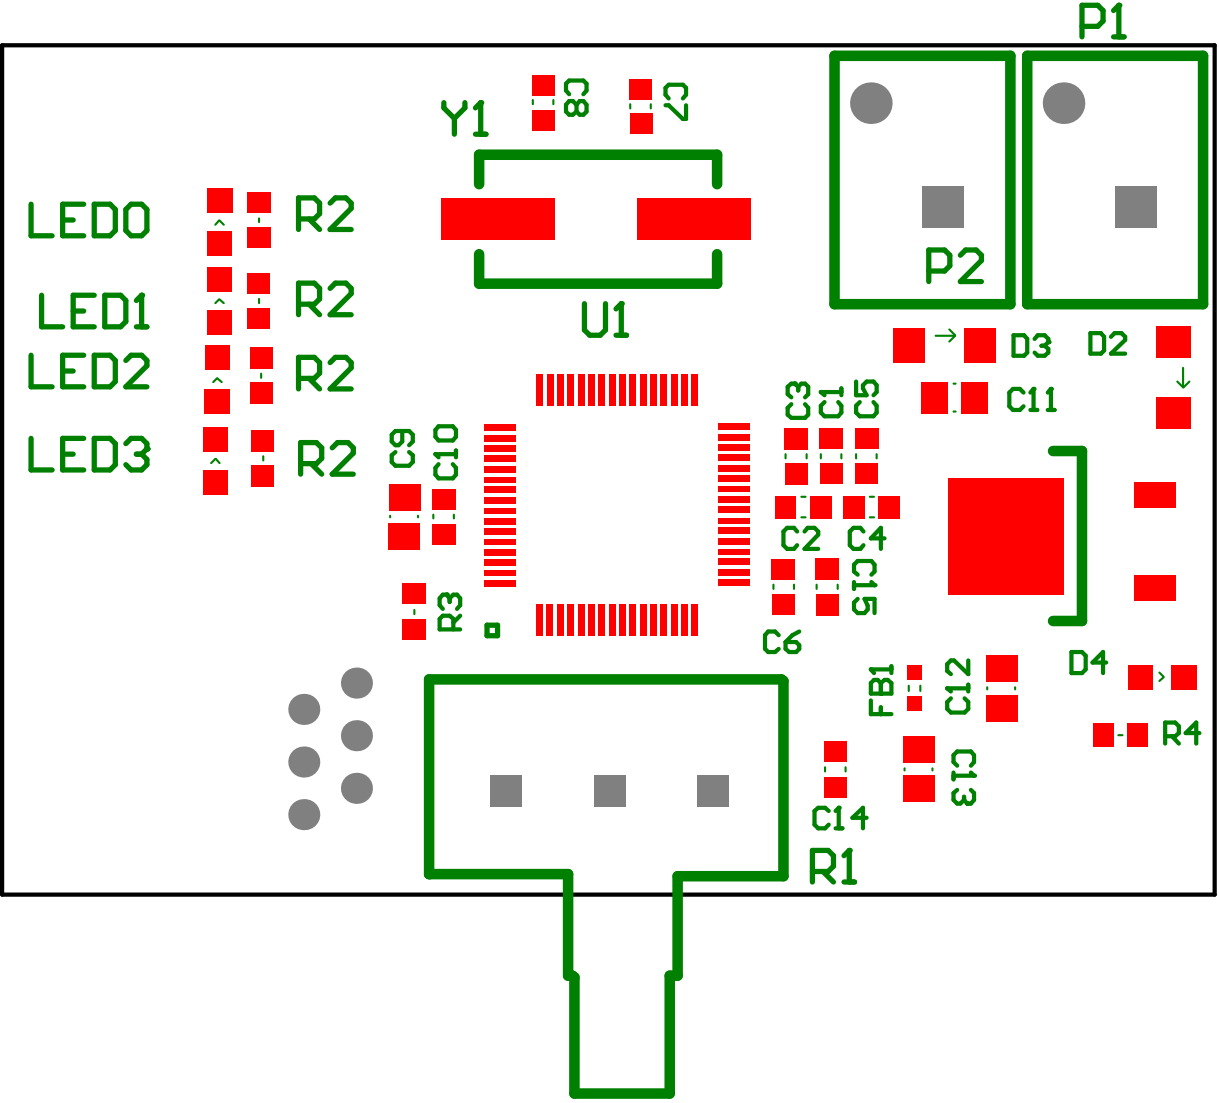
[picture p22: page 1]
