D4ryl00/42-badgotron/TP2/OUTPUT/Mechanical Drawings/Mechanical Drawings.PDF

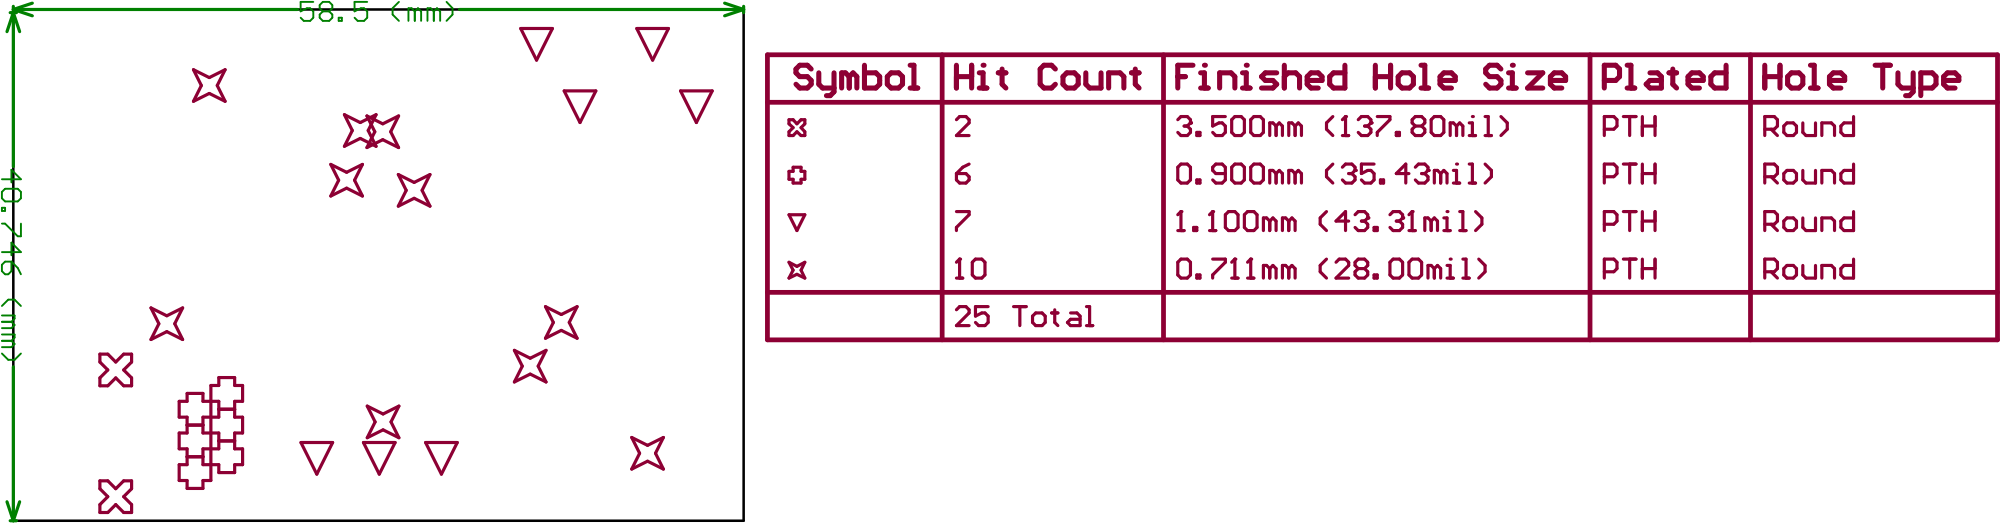
[picture p23: page 1]

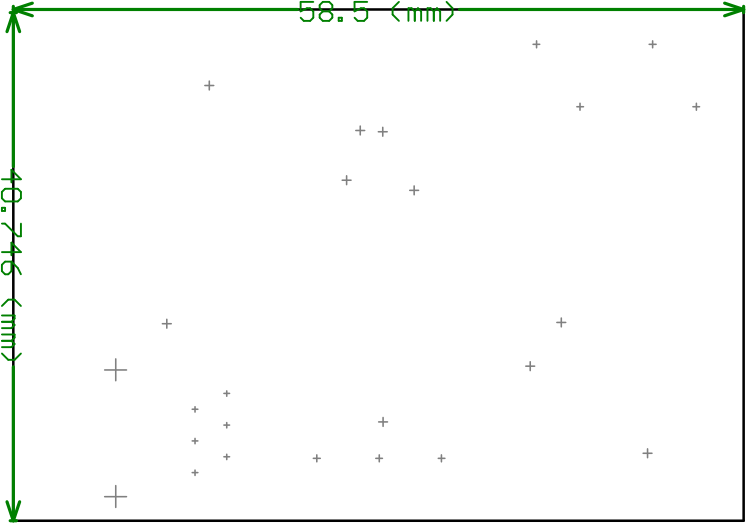
[picture p24: page 2]
