D4ryl00/42-badgotron/BADGOTRON/Schemas/Project Outputs for badgotron/Assembly Drawing/Assembly Drawing.PDF

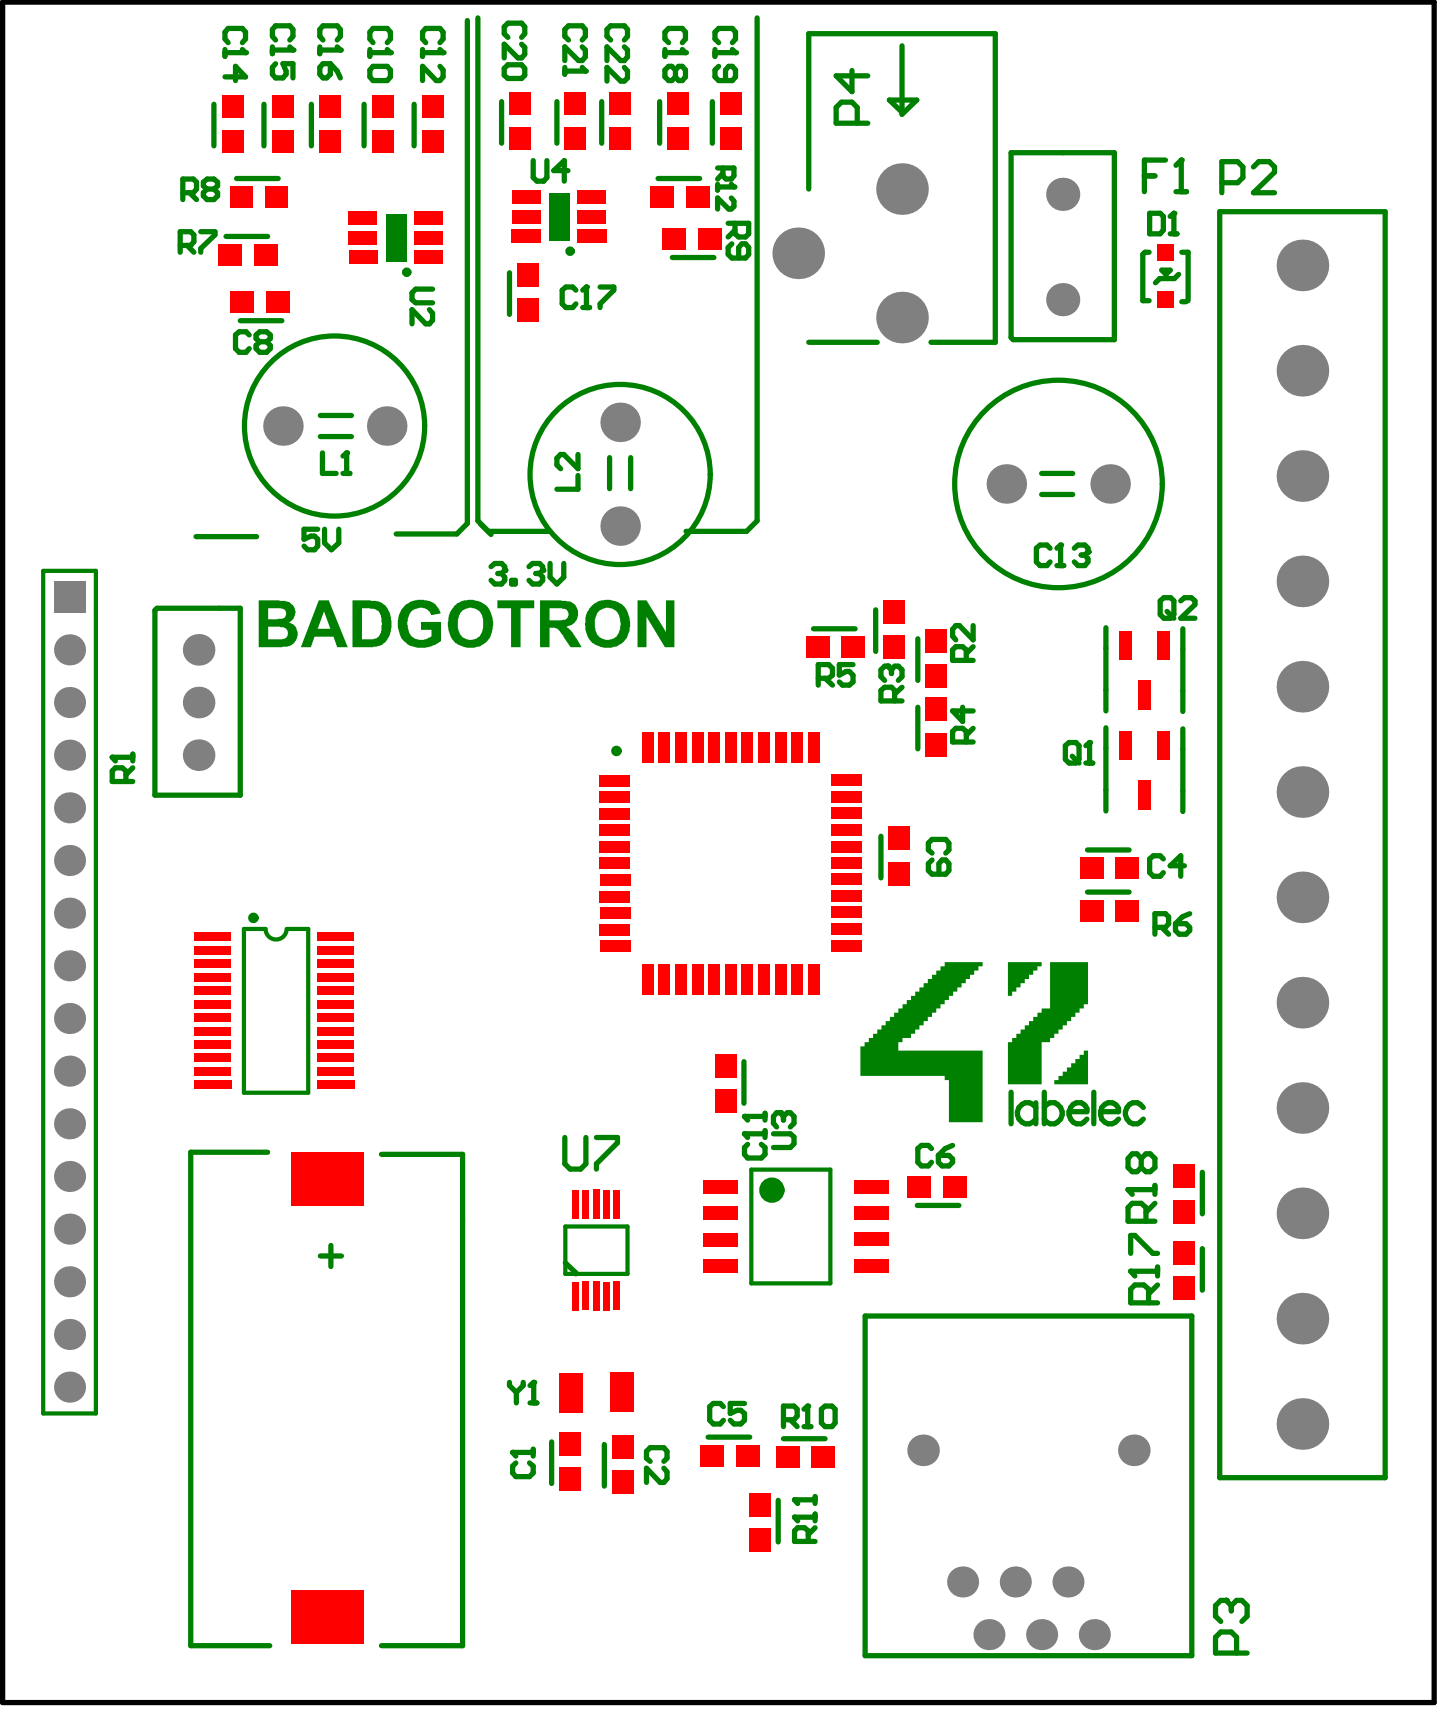
[picture p25: page 1]

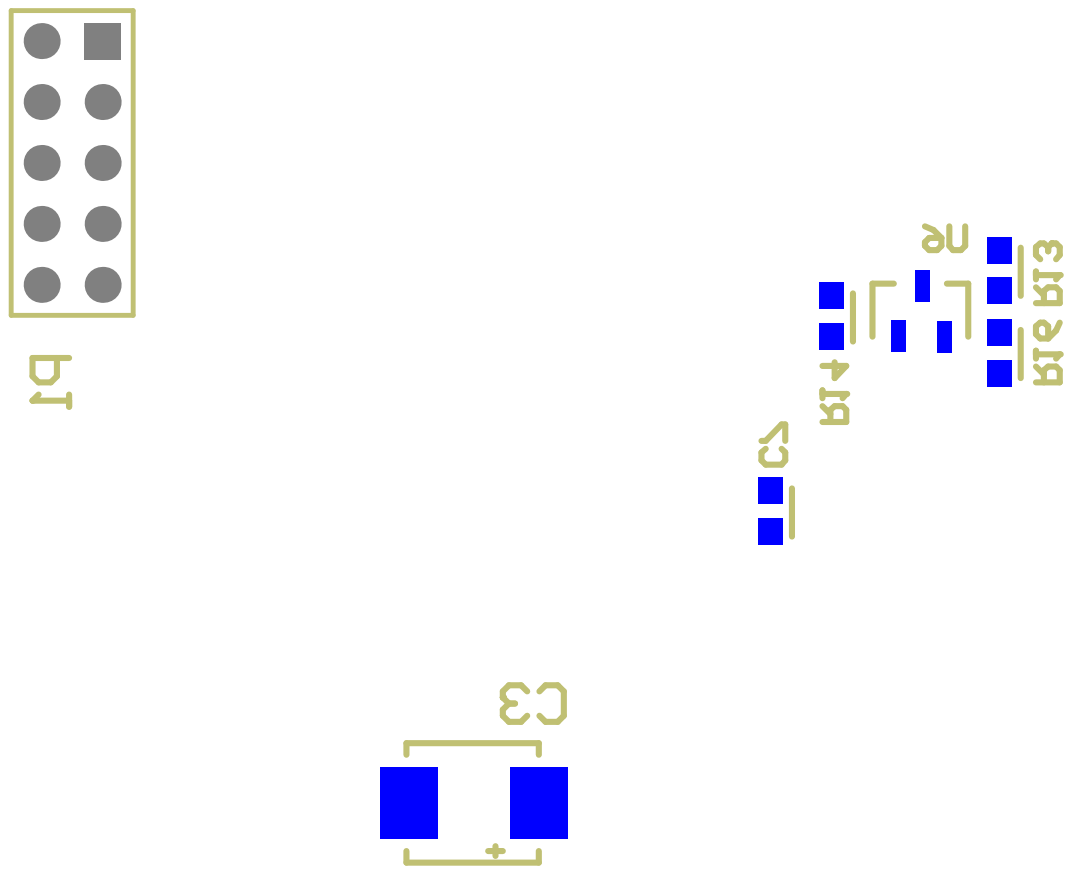
[picture p26: page 2]
