D4ryl00/42-badgotron/BADGOTRON/Schemas/Project Outputs for badgotron/Mechanical Drawing/Mechanical Drawing.PDF

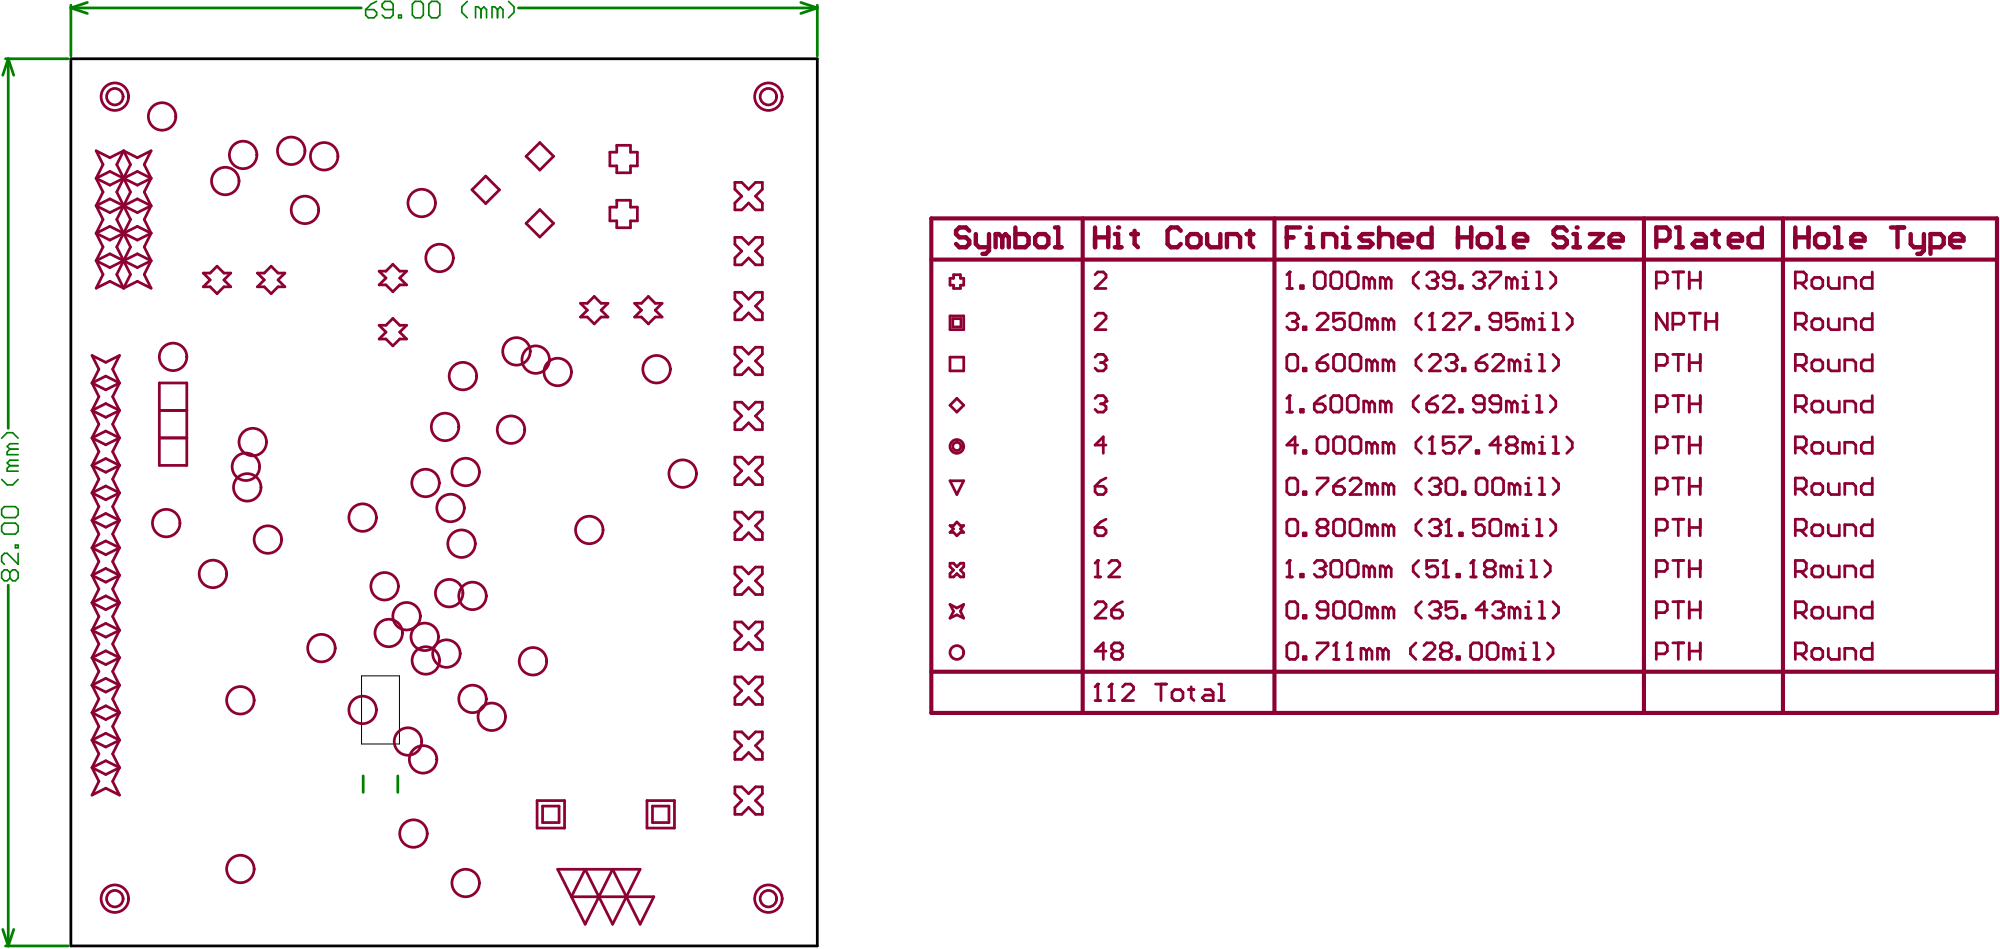
[picture p27: page 1]

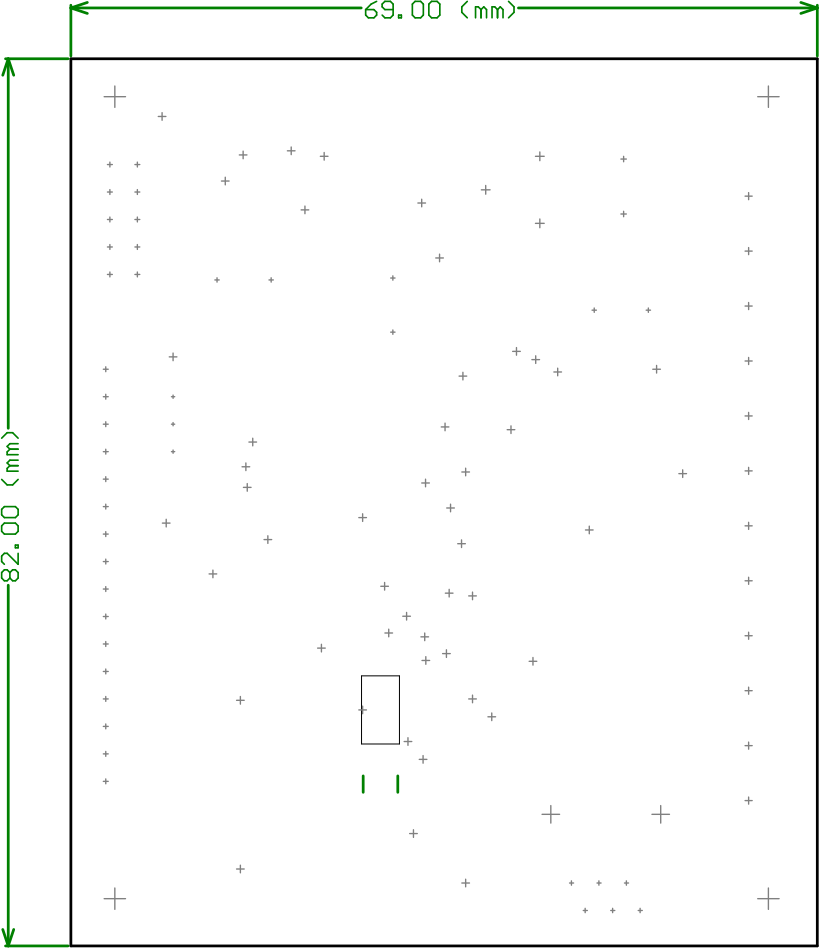
[picture p28: page 2]
