D4ryl00/42-badgotron/TP2/ZZ-POUBELLEPASSUR/Job1.PDF

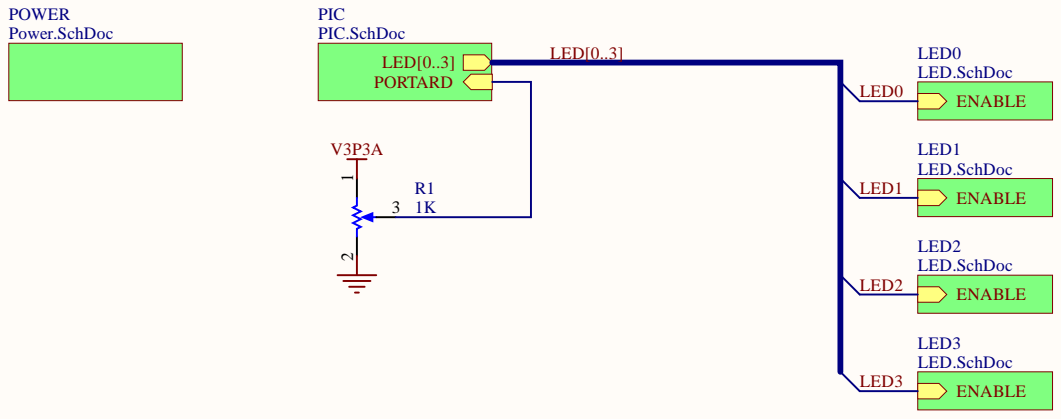
[picture p29: page 1]

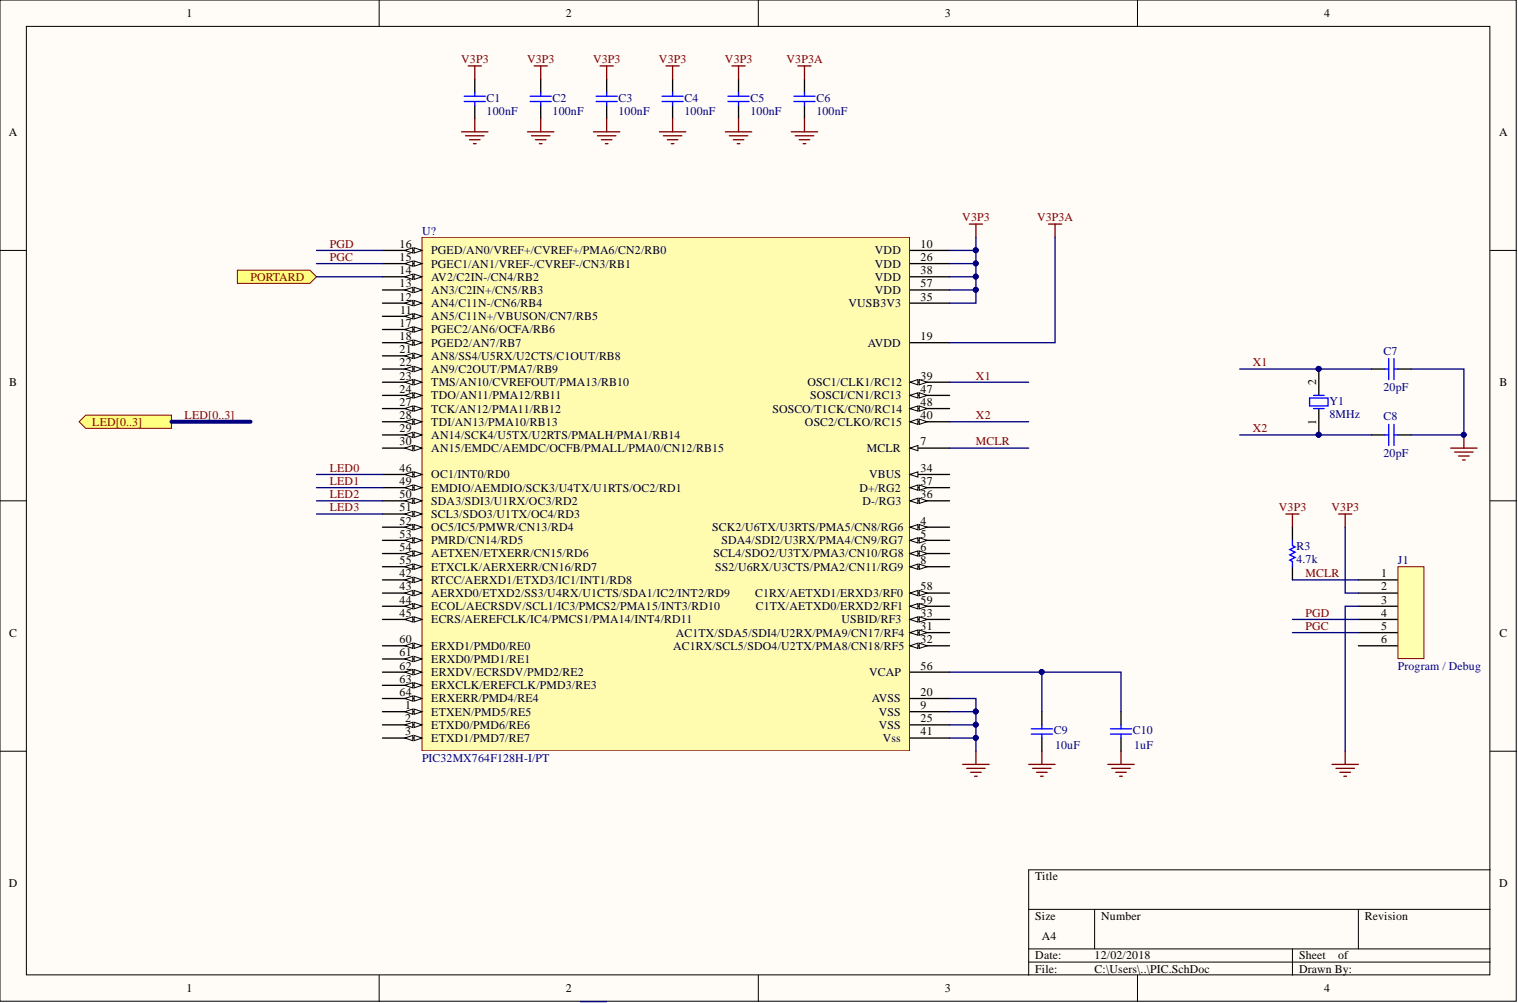
[picture p30: page 2]

2 6
3 8
5 7
3 5

2 0
2 5
4 1

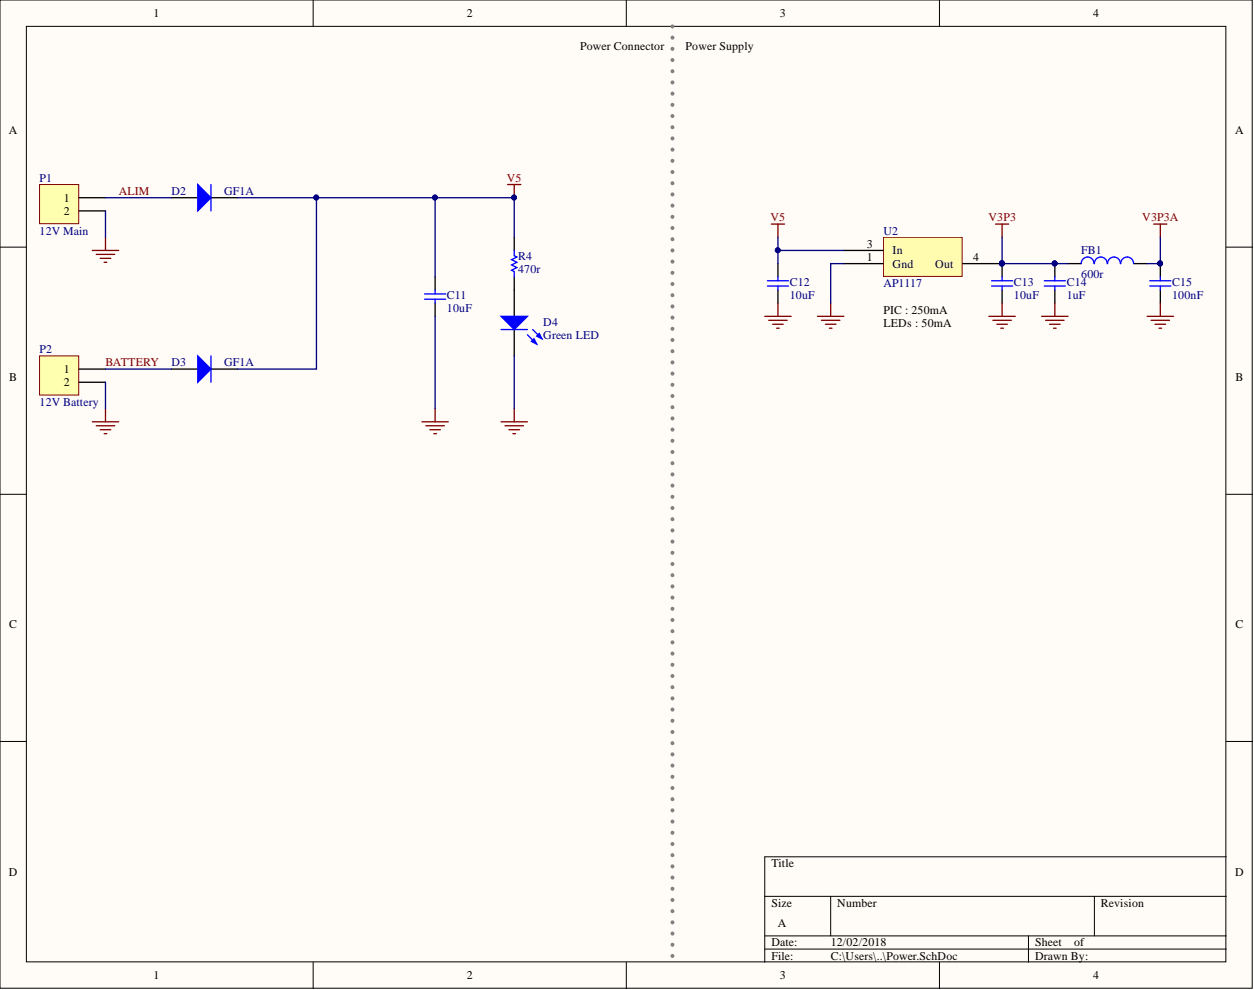
[picture p31: page 3]

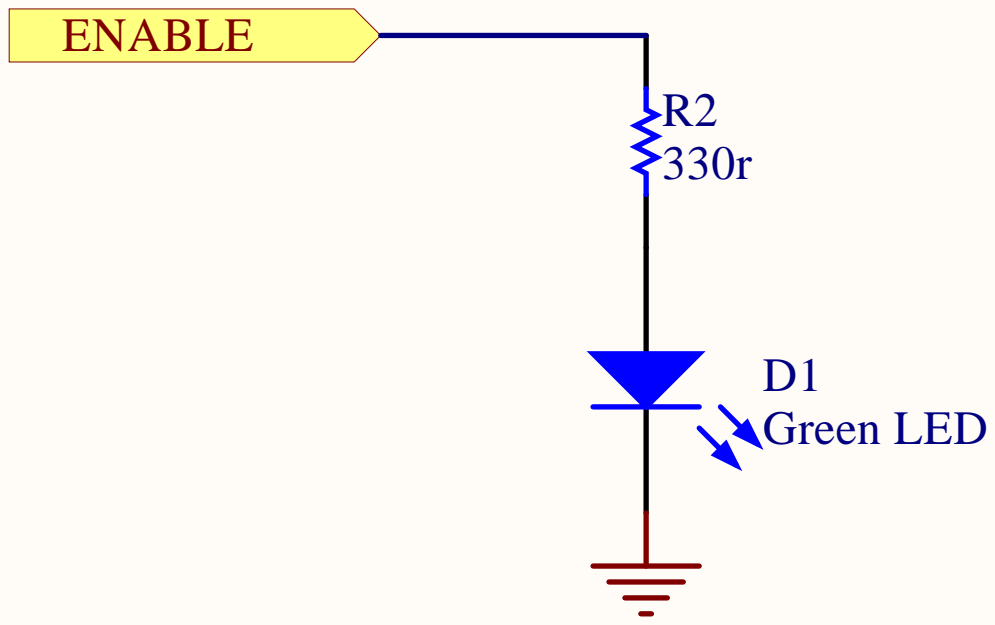
[picture p32: page 4]
