D4ryl00/42-badgotron/TP1/PCB_Project_3/Project Outputs for PCB_Project_3/Job1.PDF

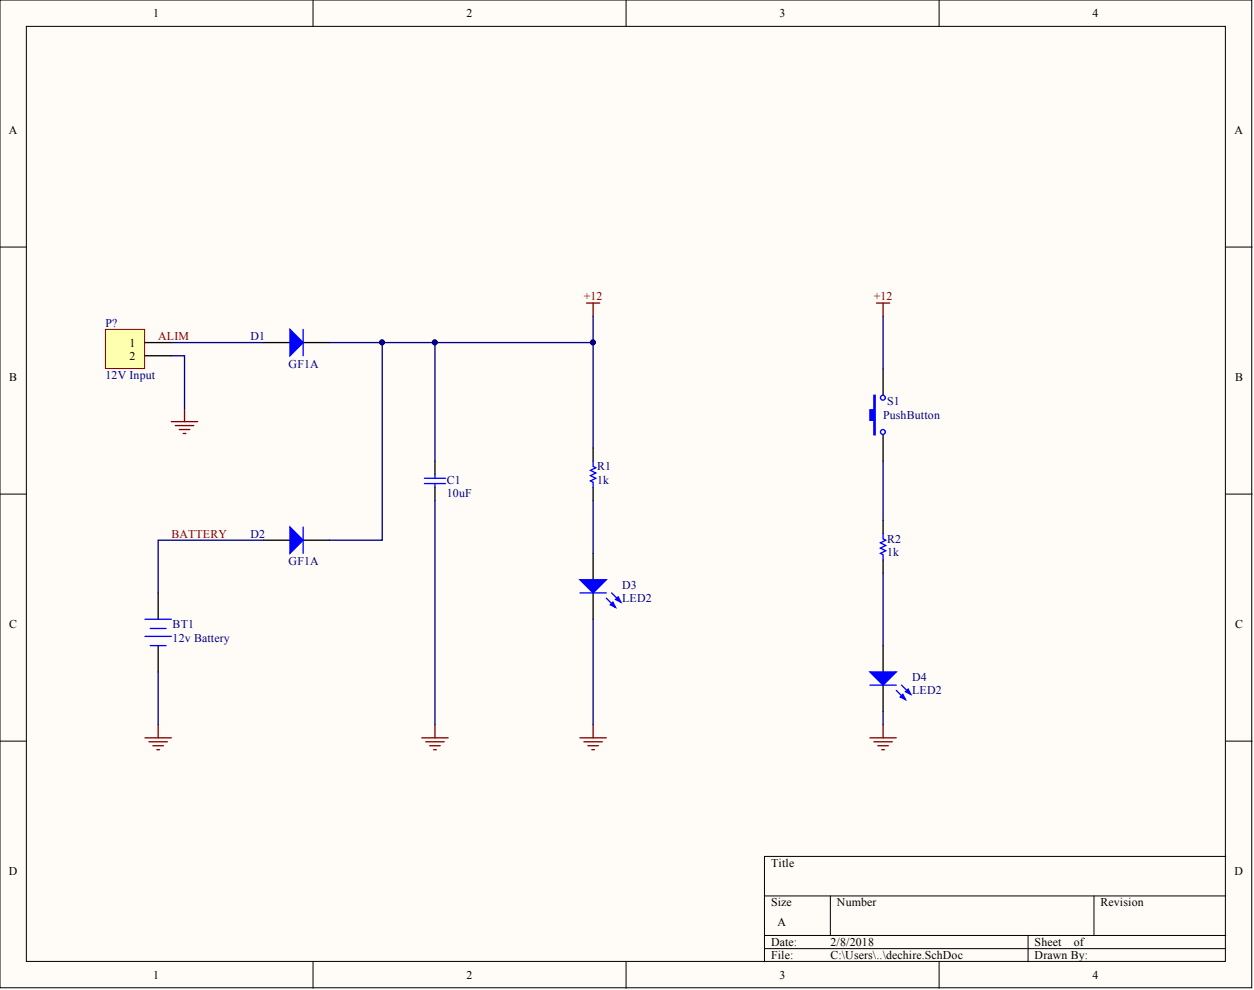
[picture p33: page 1]
