D4ryl00/42-badgotron/(list of files, drawings)

Other design files:
BADGOTRON/Schemas/A--DIVERS/Badgotron_DIVERS/Badgotron_DIVERS.PrjPcb
BADGOTRON/Schemas/badgotron.PrjPcb
BADGOTRON/Schemas/Ecran.SchDoc
BADGOTRON/Schemas/Footprints/Analog Devices Footprints.PcbLib
BADGOTRON/Schemas/Footprints/Fairchild Semiconductor Footprints.PcbLib
BADGOTRON/Schemas/HorsPCB.SchDoc
BADGOTRON/Schemas/Main.SchDoc
BADGOTRON/Schemas/old.PCB4.PcbDoc
BADGOTRON/Schemas/PCB1.PcbDoc
BADGOTRON/Schemas/PCB2.PcbDoc
BADGOTRON/Schemas/PCB3.PcbDoc
BADGOTRON/Schemas/PCB4.PcbDoc
BADGOTRON/Schemas/PCB4B4.PcbDoc
BADGOTRON/Schemas/PCB5.PcbDoc
BADGOTRON/Schemas/PcbLib1.PcbLib
BADGOTRON/Schemas/PIC.SchDoc
BADGOTRON/Schemas/Power.SchDoc
BADGOTRON/Schemas/Schlib1.SchLib
BADGOTRON/Schemas/Sheet1.SchDoc
BADGOTRON/Schemas/vraimenthorspcb.SchDoc
TP1/PCB_Project_3/dechire.SchDoc
TP1/PCB_Project_3/PCB_Project_3.PrjPcb
TP1/PCB_Project_4/PCB_Project_4.PrjPcb
TP1/PCB_Project_4/Schlib1.SchLib
TP1/PCB_Project_4/Sheet1.SchDoc
TP1/PCB_Project_4/Sheet2.SchDoc
TP2/LED.SchDoc
TP2/PCB1.PcbDoc
TP2/PCB_Project_4.PrjPcb
TP2/PcbLib1.PcbLib
TP2/PIC.SchDoc
TP2/Power.SchDoc
TP2/Schlib1.SchLib
TP2/Sheet4.SchDoc
