D4ryl00/42-badgotron/BADGOTRON/Firmware/BADGOTRON.X/servo_pin_select.h

/* 
 * File:   servo_pin_select.h
 * Author: bocal
 *
 * Created on May 24, 2018, 3:01 PM
 */

#ifndef SERVO_PIN_SELECT_H
#define	SERVO_PIN_SELECT_H

#define PIN_SERVO_MODE TRISEbits.TRISE0
#define PIN_SERVO_WRITE LATEbits.LATE0

#endif	/* SERVO_PIN_SELECT_H */
