D4ryl00/42-badgotron/badgotron2/Badgotron2.X/real_time.c

#include "badgotron.h"

s8	test_receive(void)
{
	if ((g_uart_rx_buf.buffer[0] >= '0' && g_uart_rx_buf.buffer[0] <= '9')
			&& (g_uart_rx_buf.buffer[1] >= '0' && g_uart_rx_buf.buffer[1] <= '9'))
		return (1);
	return (0);
}

u8	conv_rasp_time(u8 init, u8 test, u8 sync)
{
	u32	i;
	u32	old_ts;

	if (test && !sync)
	{
		g_rtc_time.seconds = 0x51;
		g_rtc_time.minutes = 0x05;
		g_rtc_time.hour = 0x08;
		g_rtc_time.day = 0x02;
		g_rtc_time.date = 0x01;
		g_rtc_time.month = 0x08;
		g_rtc_time.year = 0x18;
		g_rtc_time.dst = 1;
	}
	else
	{
		if (rtc_eereadword(RTC_LAST_TIMESTAMP) == 0xffffffff)
			old_ts = 1533772800;
		else
			old_ts = rtc_eereadword(RTC_LAST_TIMESTAMP);
		// seconds
		g_rtc_time.seconds = 0;
		while (g_uart_rx_buf.index < 2)
		{
			uart_putstr("time_second?\n");
			i = 1000000;
			while (!g_uart_rx_buf.index && i)
			{
				i--;
			}
			if (!i && !init)
				return (0);
			// test if we received '?' -> error
			if (g_uart_rx_buf.index < 2 || !test_receive())
				uart_clear_buffer();
		}
		g_rtc_time.seconds = g_uart_rx_buf.buffer[1] - '0';
		g_rtc_time.seconds += (g_uart_rx_buf.buffer[0] - '0') << 4;
		uart_clear_buffer();

		// minutes
		g_rtc_time.minutes = 0;
		while (g_uart_rx_buf.index < 2)
		{
			uart_putstr("time_minute?\n");
			i = 1000000;
			while (!g_uart_rx_buf.index && i)
			{
				i--;
			}
			if (!i && !init)
				return (0);
			if (g_uart_rx_buf.index < 2 || !test_receive())
				uart_clear_buffer();
		}
		g_rtc_time.minutes = g_uart_rx_buf.buffer[1] - '0';
		g_rtc_time.minutes += (g_uart_rx_buf.buffer[0] - '0') << 4;
		uart_clear_buffer();

		// hours
		g_rtc_time.hour = 0;
		while (g_uart_rx_buf.index < 2)
		{
			uart_putstr("time_hour?\n");
			i = 1000000;
			while (!g_uart_rx_buf.index && i)
			{
				i--;
			}
			if (!i && !init)
				return (0);
			if (g_uart_rx_buf.index < 2 || !test_receive())
				uart_clear_buffer();
		}
		g_rtc_time.hour = g_uart_rx_buf.buffer[1] - '0';
		g_rtc_time.hour += (g_uart_rx_buf.buffer[0] - '0') << 4;
		uart_clear_buffer();

		// day
		g_rtc_time.day = 0;
		while (g_uart_rx_buf.index < 2)
		{
			uart_putstr("time_wday?\n");
			i = 1000000;
			while (!g_uart_rx_buf.index && i)
			{
				i--;
			}
			if (!i && !init)
				return (0);
			if (g_uart_rx_buf.index < 2 || !test_receive())
				uart_clear_buffer();
		}
		g_rtc_time.day = g_uart_rx_buf.buffer[1] - '0';
		g_rtc_time.day += (g_uart_rx_buf.buffer[0] - '0') << 4;
		uart_clear_buffer();

		// date
		g_rtc_time.date = 0;
		while (g_uart_rx_buf.index < 2)
		{
			uart_putstr("time_day?\n");
			i = 1000000;
			while (!g_uart_rx_buf.index && i)
			{
				i--;
			}
			if (!i && !init)
				return (0);
			if (g_uart_rx_buf.index < 2 || !test_receive())
				uart_clear_buffer();
		}
		g_rtc_time.date = g_uart_rx_buf.buffer[1] - '0';
		g_rtc_time.date += (g_uart_rx_buf.buffer[0] - '0') << 4;
		uart_clear_buffer();

		// month
		g_rtc_time.month = 0;
		while (g_uart_rx_buf.index < 2)
		{
			uart_putstr("time_month?\n");
			i = 1000000;
			while (!g_uart_rx_buf.index && i)
			{
				i--;
			}
			if (!i && !init)
				return (0);
			if (g_uart_rx_buf.index < 2 || !test_receive())
				uart_clear_buffer();
		}
		g_rtc_time.month = g_uart_rx_buf.buffer[1] - '0';
		g_rtc_time.month += (g_uart_rx_buf.buffer[0] - '0') << 4;
		uart_clear_buffer();

		// year
		g_rtc_time.year = 0;
		while (g_uart_rx_buf.index < 2)
		{
			uart_putstr("time_year?\n");
			i = 1000000;
			while (!g_uart_rx_buf.index && i)
			{
				i--;
			}
			if (!i && !init)
				return (0);
			if (g_uart_rx_buf.index < 2 || !test_receive())
				uart_clear_buffer();
		}
		g_rtc_time.year = g_uart_rx_buf.buffer[1] - '0';
		g_rtc_time.year += (g_uart_rx_buf.buffer[0] - '0') << 4;
		uart_clear_buffer();

		while (g_uart_rx_buf.index < 2)
		{
			uart_putstr("time_dst?\n");
			i = 1000000;
			while (!g_uart_rx_buf.index && i)
			{
				i--;
			}
			if (!i && !init)
				return (0);
			if (g_uart_rx_buf.index < 2 || !test_receive())
				uart_clear_buffer();
		}
		g_rtc_time.dst = g_uart_rx_buf.buffer[1] - '0';
		if (get_timestamp() < 1533772800 || (s32)(old_ts - get_timestamp()) > 3600)
			return (0);
	}
	return (1);
}

void	print_time(void)
{
	display_printchar((g_rtc_time.hour >> 4) + '0');
	display_printchar((g_rtc_time.hour & 0x0f) + '0');
	display_printstr(":");
	display_printchar((g_rtc_time.minutes >> 4) + '0');
	display_printchar((g_rtc_time.minutes & 0x0f) + '0');
	display_printstr(":");
	display_printchar((g_rtc_time.seconds >> 4) + '0');
	display_printchar((g_rtc_time.seconds & 0x0f) + '0');
}

void	print_date(void)
{
	display_printchar((g_rtc_time.date >> 4) + '0');
	display_printchar((g_rtc_time.date & 0x0f) + '0');
	display_printstr("/");
	display_printchar((g_rtc_time.month >> 4) + '0');
	display_printchar((g_rtc_time.month & 0x0f) + '0');
	display_printstr("/");
	display_printchar((g_rtc_time.year >> 4) + '0');
	display_printchar((g_rtc_time.year & 0x0f) + '0');
}

void	print_hours(u32 minutes, u8 spaces, u8 padding)
{
	u8 digits;
	u32 hours = minutes / 60;

	digits = -1;
	while (++digits < spaces)
		display_printstr(" ");
	digits = 1;
	while (hours >= 10)
	{
		hours /= 10;
		digits++;
	}
	while (digits < padding)
	{
		display_printstr(" ");
		digits++;
	}
	putnbr(minutes / 60);
	display_printstr("h");
	if ((minutes % 60) < 10)
		display_printchar('0');
	putnbr(minutes % 60);
}

u32	get_timestamp(void)
{
	t_rtc_time	time;
	u32			timestamp;
	u8			calendar [] = {31, 28, 31, 30
					,31, 30, 31, 31
					,30, 31, 30, 31};

	//convert date from bcd format to decimal
	time.year = ((g_rtc_time.year >> 4) * 10) + (g_rtc_time.year & 0x0f);
	time.month = ((g_rtc_time.month >> 4) * 10) + (g_rtc_time.month & 0x0f);
	time.date = ((g_rtc_time.date >> 4) * 10) + (g_rtc_time.date & 0x0f);
	time.hour = ((g_rtc_time.hour >> 4) * 10) + (g_rtc_time.hour & 0x0f);
	time.minutes = ((g_rtc_time.minutes >> 4) * 10) + (g_rtc_time.minutes & 0x0f);
	time.seconds = ((g_rtc_time.seconds >> 4) * 10) + (g_rtc_time.seconds & 0x0f);
	timestamp = 0;
	if ((!((time.year + 2000) % 4)) && (time.month > 2))
		timestamp += 86400; // if the current year is a leap one -> add one day (86400 sec)
	while (time.month > 1) // sum the days from January to the current month
	{
		time.month--; // dec the month
		timestamp += (calendar[time.month]) * 86400 ; // add the number of days from a month * 86400 sec
	}
	timestamp += ((time.year + 30) / 4) * (3600 * 24);
	timestamp += (time.year + 30) * (3600*24*365);
	timestamp += (time.date - 1) * (3600 * 24);
	timestamp += time.hour * 3600;
	timestamp += time.minutes * 60;
	timestamp += time.seconds;
	if (g_rtc_time.dst)
		timestamp -= 3600 * 2;
	else
		timestamp -= 3600;
	return (timestamp);
}
