D4ryl00/42-badgotron/badgotron2/Badgotron2.X/spi.c

#include "badgotron.h"

void	init_spi(void)
{
	u32	rData;

	PIN_FLASH_ANALOG = 0;
	PIN_FLASH_MODE = 0;
	PIN_FLASH_WRITE = 1;
	PIN_RTC_MODE = 0;
	PIN_RTC_WRITE = 1;

	/* Disable SPI interrupt */
	IEC1bits.SPI2EIE = 0;
	IEC1bits.SPI2RXIE = 0;
	IEC1bits.SPI2TXIE = 0;
	/* Stop SPI module */
	SPI2CONbits.ON = 0;
	/* Clearing the receive buffer */
	rData = SPI2BUF;
	/* Set Baud Rate = PBCLK / 2 */
	SPI2BRG = 3;
	/* Standard Mode */
	SPI2CONbits.ENHBUF = 0;
	/* Disable Slave Select */
	SPI2CONbits.MSSEN = 0;
	/* clear the SPIROV bit */
	SPI2STATbits.SPIROV = 0;
	/* Set settings */
	/* Set Clock Edge */
	SPI2CONbits.CKE = 1;
	SPI2CONbits.CKP = 0;
	/* 8 bits communication */
	SPI2CONbits.MODE32 = 0;
	SPI2CONbits.MODE16 = 0;
	/* Master ON */
	SPI2CONbits.MSTEN = 1;
	/* Stop SPI module */
	SPI2CONbits.ON = 1;
}

void	spi_select_slave(enum e_spi_slave slave)
{
	if (slave == FLASH)
	{
		PIN_FLASH_WRITE = UNSELECTED;
		PIN_FLASH_WRITE = SELECTED;
	}
	else if (slave == RTC)
	{
		PIN_RTC_WRITE = UNSELECTED;
		PIN_RTC_WRITE = SELECTED;
	}
}

void	spi_unselect_slave(enum e_spi_slave slave)
{
	if (slave == FLASH)
	{
		PIN_FLASH_WRITE = SELECTED;
		PIN_FLASH_WRITE = UNSELECTED;
	}
	else if (slave == RTC)
	{
		PIN_RTC_WRITE = SELECTED;
		PIN_RTC_WRITE = UNSELECTED;
	}
}

void	spi_transfer(u8 tx_byte, u8* rx_byte)
{
    SPI2BUF = tx_byte;
    while(!SPI2STATbits.SPIRBF);
    *rx_byte = SPI2BUF;
}
