D4ryl00/42-badgotron/badgotron2/Badgotron2.X/led_rg.h

/* 
 * File:   led_rg.h
 * Author: bocal
 *
 * Created on July 20, 2018, 3:25 PM
 */

#ifndef LED_RG_H
#define	LED_RG_H

#ifdef	__cplusplus
extern "C" {
#endif

#ifdef	__cplusplus
}
#endif

#endif	/* LED_RG_H */
