D4ryl00/42-badgotron/badgotron2/Badgotron2.X/types.h

/* 
 * File:   types.h
 * Author: bocal
 *
 * Created on May 9, 2018, 2:48 PM
 */

#ifndef TYPES_H
#define	TYPES_H

#ifdef	__cplusplus
extern "C" {
#endif

typedef unsigned char   u8;
typedef signed char     s8;
typedef unsigned short  u16;
typedef signed short    s16;
typedef unsigned long   u32;
typedef signed long     s32;


#ifdef	__cplusplus
}
#endif

#endif	/* TYPES_H */
