D4ryl00/42-badgotron/caketron2/caketron2.X/header.h

/* 
 * File:   header.h
 * Author: bocal
 *
 * Created on March 23, 2018, 3:54 PM
 */

#ifndef HEADER_H
#define	HEADER_H

#ifdef	__cplusplus
extern "C" {
#endif




#ifdef	__cplusplus
}
#endif

#endif	/* HEADER_H */
