D4ryl00/42-badgotron/(commit log)

2018-02-12 Adrien - TP2OK
    [Bill of Materials-PCB_Project_4.xlsx, LED.SchDoc, PCB_Project_3.PrjPcb, PCB_Project_4.PrjPcb, PIC.SchDoc, Power.SchDoc, Schlib1.SchLib, Sheet1.SchDoc]
2018-03-07 adri 07/03 13:31
    [Schlib1.SchLib, Sheet1.SchDoc, badgotron.PrjPcb]
2018-03-07 adri 07/03 13:40
    [Sheet1.SchDoc]
2018-03-07 adri 07/03 13:51
    [PIC.SchDoc, Power.SchDoc, Schlib1.SchLib, Sheet1.SchDoc, badgotron.PrjPcb]
2018-03-07 Adri 07/03 14:49
    [Power.SchDoc, Schlib1.SchLib]
2018-03-07 adri 07/03 16:24
    [Ecran.SchDoc, PIC.SchDoc, Power.SchDoc, Schlib1.SchLib]
2018-03-07 Adri 07/03 18:14
    [Ecran.SchDoc, PIC.SchDoc, Schlib1.SchLib]
2018-03-07 adri 07/03 20:41
    [Ecran.SchDoc, PIC.SchDoc, Power.SchDoc, Schlib1.SchLib, Vumetre.SchDoc, badgotron.PrjPcb]
2018-03-07 Adri 07/03 21:55
    [Ecran.SchDoc, PIC.SchDoc, Power.SchDoc, Power_bouton.SchDoc, Schlib1.SchLib, Vumetre.SchDoc, Vumetre_Lecteur.SchDoc, badgotron.PrjPcb]
2018-03-07 Adri 07/03 22:46
    [HorsPCB.SchDoc, PIC.SchDoc, Power.SchDoc, Power_bouton.SchDoc, Schlib1.SchLib, Vumetre_Lecteur.SchDoc, badgotron.PrjPcb]
2018-03-07 Adri 07/03 22:58
    [HorsPCB.SchDoc, Main.SchDoc, PIC.SchDoc, badgotron.PrjPcb]
2018-03-09 fuck 2
    [PcbLib1.PcbLib]
2018-03-12 monday fuck
    [PCB1.PcbDoc]
2018-03-12 we we c tre bi1
    [PCB1.PcbDoc]
2018-03-12 encore mieux quand cest enregistre loooooooooollll tas vu trankil
    [PCB1.PcbDoc, PCB_Project_4.PrjPcb]
2018-03-15 fucking tuesday
    [PCB1.PcbDoc, PCB_Project_4.PrjPcb, PcbLib1.PcbLib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]
2018-03-16 tp3 fuck
    [PCB1.PcbDoc, PcbLib1.PcbLib]
2018-03-21 shit
    shit
    [BOM.xls.xlsx, Bill of Materials-PCB_Project_4.xlsx, Bill of Materials.xls, LED.SchDoc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]
2018-03-21 ok
    ok
    [BOM.xls.xlsx, Bill of Materials-PCB_Project_4.xlsx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]
2018-04-04 OK interrupts
2018-04-12 dsfsdf
    sdf
    [Ecran.SchDoc, HorsPCB.SchDoc, PIC.SchDoc, Power.SchDoc, Schlib1.SchLib]
2018-04-17 dasd
    asd
    [HorsPCB.SchDoc, PIC.SchDoc, Power.SchDoc, Schlib1.SchLib, Sheet1.SchDoc, badgotron.PrjPcb]
2018-04-17 opregj
    pjofer
    [Badgotron_DIVERS.PrjPcb, Bill of Materials-badgotron.xlsx, Ecran.SchDoc, HorsPCB.SchDoc, Main.SchDoc, PIC.SchDoc, Power.SchDoc, Schlib1.SchLib]
2018-04-23 fds
    dsf
    [Ecran.SchDoc, HorsPCB.SchDoc, PIC.SchDoc, Power.SchDoc, Schlib1.SchLib]
2018-04-24 hrtrht
    hrthr
    [Bill of Materials-badgotron.xlsx, Ecran.SchDoc, HorsPCB.SchDoc, Main.SchDoc, PIC.SchDoc, Power.SchDoc, Schlib1.SchLib, badgotron.PrjPcb]
2018-04-24 wqdq
    qwd
    [Bill of Materials-badgotron.xlsx, Power.SchDoc]
2018-05-03 bxb
    fghfg
    [Bill of Materials-badgotron.xlsx, HorsPCB.SchDoc, PIC.SchDoc, Power.SchDoc, badgotron.PrjPcb, vraimenthorspcb.SchDoc]
2018-05-07 ewfef
    we
    [Bill of Materials-badgotron.xlsx, Ecran.SchDoc, HorsPCB.SchDoc, PIC.SchDoc, Power.SchDoc, Schlib1.SchLib]
2018-05-09 fg
    gf
    [Badgotron_DIVERS.PrjPcb, Bill of Materials-badgotron.xlsx, Ecran.SchDoc, HorsPCB.SchDoc, Main.SchDoc, PIC.SchDoc, PcbLib1.PcbLib, Power.SchDoc]
2018-05-17 init firmware
    fgfgf
    [Bill of Materials-badgotron.xlsx]
2018-05-24 56ju
    65uy
    [Bill of Materials-badgotron.xlsx, PIC.SchDoc, Schlib1.SchLib]
2018-05-29 UART RX OK
    putain de bordel de merde
2018-05-30 enhanced uart
2018-05-30 spi init
2018-06-01 spi works
2018-06-01 der
    efr
2018-06-01 fre
    ge
    [Analog Devices Footprints.PcbLib, Fairchild Semiconductor Footprints.PcbLib, PcbLib1.PcbLib, Schlib1.SchLib, badgotron.PrjPcb]
2018-06-01 footprint PIC OK
    dw
    [PcbLib1.PcbLib, Schlib1.SchLib]
2018-06-04 dsa
    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
    [PcbLib1.PcbLib, Power.SchDoc, Schlib1.SchLib]
2018-06-04 fe
    fw
    [Ecran.SchDoc, HorsPCB.SchDoc, PIC.SchDoc, PcbLib1.PcbLib, Power.SchDoc, Schlib1.SchLib]
2018-06-05 sadfew
    asdasd
    [PIC.SchDoc, PcbLib1.PcbLib, Power.SchDoc]
2018-06-05 sdf
    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
    [HorsPCB.SchDoc, Main.SchDoc, PIC.SchDoc, PcbLib1.PcbLib, Power.SchDoc, vraimenthorspcb.SchDoc]
2018-06-05 csaca
    cas
    [Main.SchDoc, PCB1.PcbDoc, PIC.SchDoc, PcbLib1.PcbLib, Power.SchDoc, badgotron.PrjPcb, vraimenthorspcb.SchDoc]
2018-06-05 sdfsd
    fsdf
    [PCB1.PcbDoc, PcbLib1.PcbLib, Power.SchDoc]
2018-06-07 few
    w
    [Ecran.SchDoc, PCB1.PcbDoc, PIC.SchDoc, PcbLib1.PcbLib, Power.SchDoc]
2018-06-07 schemas OK - Nouveaux convert. tension - Nouvelle PCB
    [Ecran.SchDoc, HorsPCB.SchDoc, Main.SchDoc, PCB1.PcbDoc, PCB2.PcbDoc, PIC.SchDoc, PcbLib1.PcbLib, Power.SchDoc]
2018-06-07 dasdas
    dasd
    [PCB2.PcbDoc, PcbLib1.PcbLib]
2018-06-08 sfd
    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
    [Bill of Materials-badgotron.xlsx, HorsPCB.SchDoc, PCB2.PcbDoc, PIC.SchDoc]
2018-06-08 ok
    k
    [PCB2.PcbDoc]
2018-06-13 mosfet 1 OK
    [HorsPCB.SchDoc, PCB2.PcbDoc, PcbLib1.PcbLib]
2018-06-13 mosfets OK
    [PCB2.PcbDoc]
2018-06-13 sdfs
    fdsd
    [badgotron.PrjPcb]
2018-06-13 header raspi OK
    dfewf
    [PCB2.PcbDoc, PcbLib1.PcbLib]
2018-06-13 37 <-> 14
    [PCB2.PcbDoc, PIC.SchDoc]
2018-06-13 sada
    sdasdad
    [Ecran.SchDoc, PCB2.PcbDoc, PcbLib1.PcbLib]
2018-06-13 asda
    sdada
    [PCB2.PcbDoc]
2018-06-20 sfdsd
    fsf
    [PCB2.PcbDoc, PcbLib1.PcbLib, Power.SchDoc]
2018-06-21 reg 5v
    [Power.SchDoc, badgotron.PrjPcb]
2018-06-21 repcb suite
    [PCB3.PcbDoc, PCB4.PcbDoc, PIC.SchDoc, PcbLib1.PcbLib, Power.SchDoc, badgotron.PrjPcb]
2018-06-21 continuing pcb v4
    [PCB4.PcbDoc, PIC.SchDoc, PcbLib1.PcbLib, Schlib1.SchLib]
2018-06-22 wqfwe
    fwefwe
    [PCB4.PcbDoc, PCB4B4.PcbDoc, PCB5.PcbDoc, PcbLib1.PcbLib]
2018-06-22 grerg
    erger
    [badgotron.PrjPcb]
2018-07-04 pcb final (maybe)
    [Bill of Materials-badgotron.xlsx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]
2018-07-04 fds
    fsd
    [Gestion_FLASH.xlsx]
2018-07-05 schemas ok
    [Bill of Materials-badgotron.xlsx, PCB4.PcbDoc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]
2018-07-05 rthrt
    trhrth
    [Gestion_FLASH.xlsx]
2018-07-09 pbclk x8
    [Gestion_FLASH.xlsx]
2018-07-10 flash ok
    [Gestion_FLASH.xlsx]
2018-07-11 plein de choses cool
    [Gestion_FLASH.xlsx]
2018-07-12 design boite de merde
2018-07-13 rtc_alarm daily ok
    [Gestion_FLASH.xlsx]
2018-07-17 PowerSave OK
2018-07-19 working servo hardware pwm
2018-07-20 pwm ok
2018-07-20 leds rg ok
2018-08-06 converting to new pic
    [badgotron.PrjPcb]
2018-08-09 OK pour lire en UART la commande name_1234934293842 et repondre prenom donné par script api.py
2018-09-04 notice + fix adding hour after badge
    [badge.c]
